HonkStonk/AeroQuad/Documentation/Architecture/AeroQuadSoftwareFlowDiagram.png

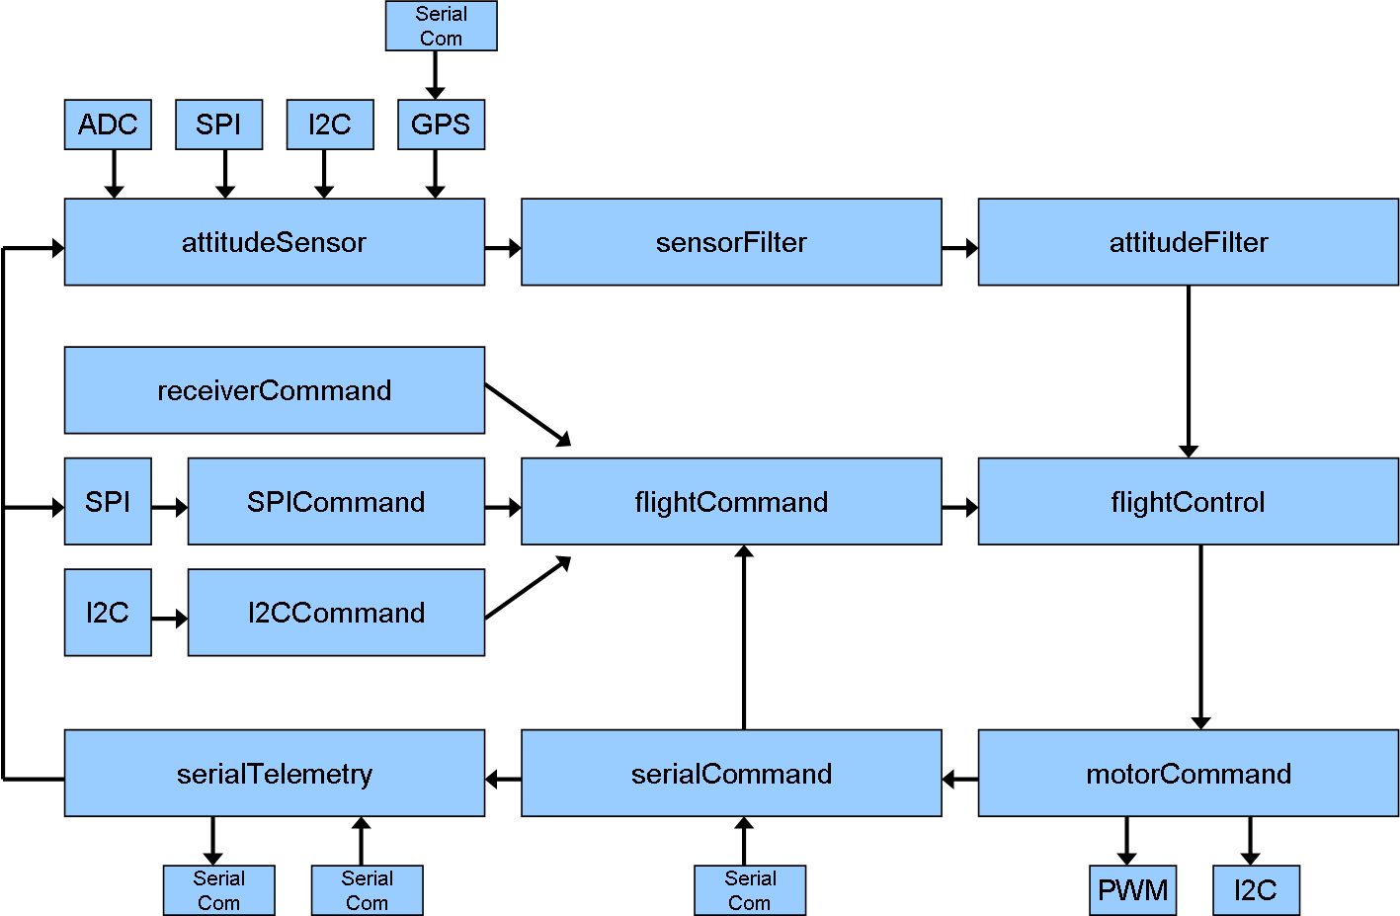
Documentation/Architecture/AeroQuadSoftwareFlowDiagram.png
