HonkStonk/AeroQuad/Documentation/InterconnectDiagram/v1.7/AeroQuadInterconnectDiagram_v1.7.jpg

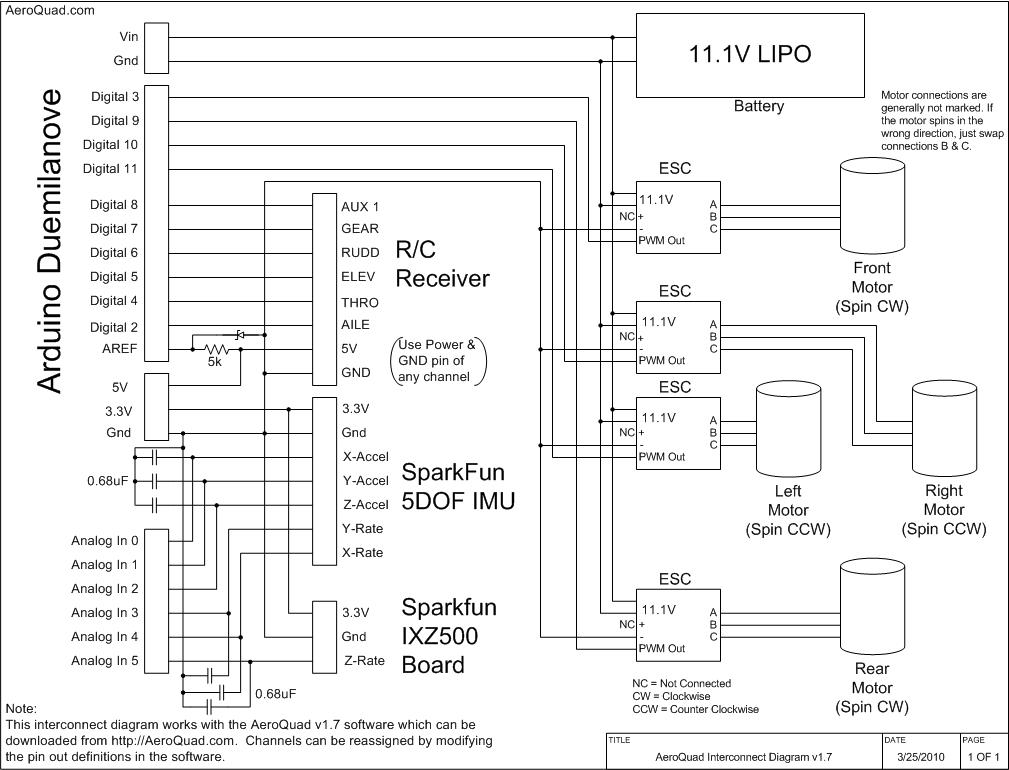
Documentation/InterconnectDiagram/v1.7/AeroQuadInterconnectDiagram_v1.7.jpg
