HonkStonk/AeroQuad/Documentation/Frame/v3.0/AeroQuadFrame_v3.dxf

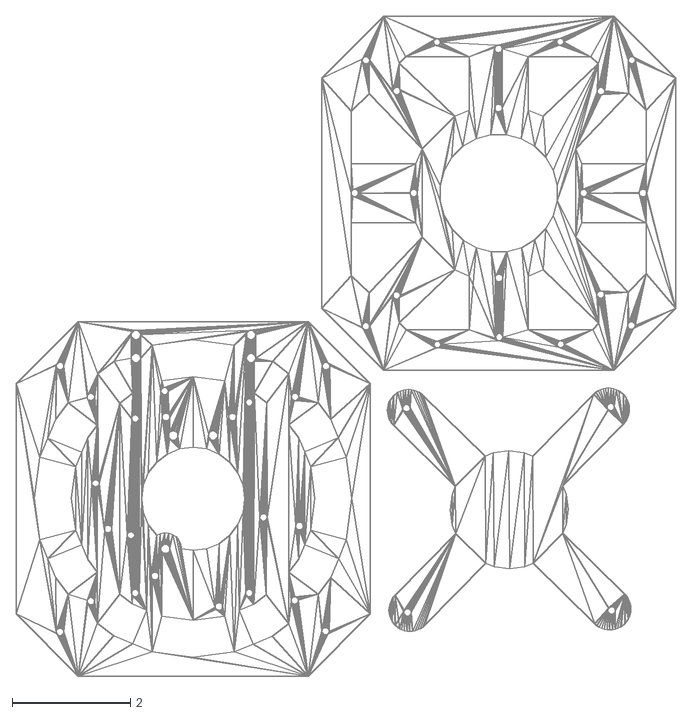
[picture p4: CAD file, 2010-09-20]
Documentation/Frame/v3.0/AeroQuadFrame_v3.dxf
11.2 x 11.2
