HonkStonk/AeroQuad/(list of files, cad)

Other CAD files:
Documentation/Frame/v1.0/Bottom.skp
Documentation/Frame/v1.0/BottomArm.skp
Documentation/Frame/v1.0/BottomSidePlate3D_125.skp
Documentation/Frame/v1.0/BottomSidePlate_125.skp
Documentation/Frame/v1.0/BottomSide_125.skp
Documentation/Frame/v1.0/Bottom_125.skp
Documentation/Frame/v1.0/QuadrocopterArm(bottom-side).skp
Documentation/Frame/v1.0/QuadrocopterArm.skp
Documentation/Frame/v1.1/BasePlates.skp
Documentation/Frame/v1.1/BottomSidePlatev2.skp
Documentation/Frame/v1.1/QuadArms.skp
Documentation/Frame/v1.1/QuadArms3D.skp
Documentation/Frame/v1.1/Xstruts.skp
Documentation/Frame/v1.2/BasePlates_v1.2.skp
Documentation/Frame/v1.2/QuadArms_v1.2.skp
Documentation/Frame/v1.2/Quad_v1.2.skp
Documentation/Frame/v2.0/12-5mmTubeMounts.skp
Documentation/Frame/v2.0/12-7mmTubeMounts.skp
Documentation/Frame/v2.0/AeroQuadFrame_v2.0.skp
Documentation/Frame/v2.1/12-7mmTubeMounts.skp
Documentation/Frame/v2.1/AeroQuadFrame3D_v2.1.skp
Documentation/Frame/v2.1/AeroQuadFrame_v2.1.skp
