HonkStonk/AeroQuad/Documentation/Shield/AeroQuad_v2.0/AeroQuad_v206_Schematic.pdf

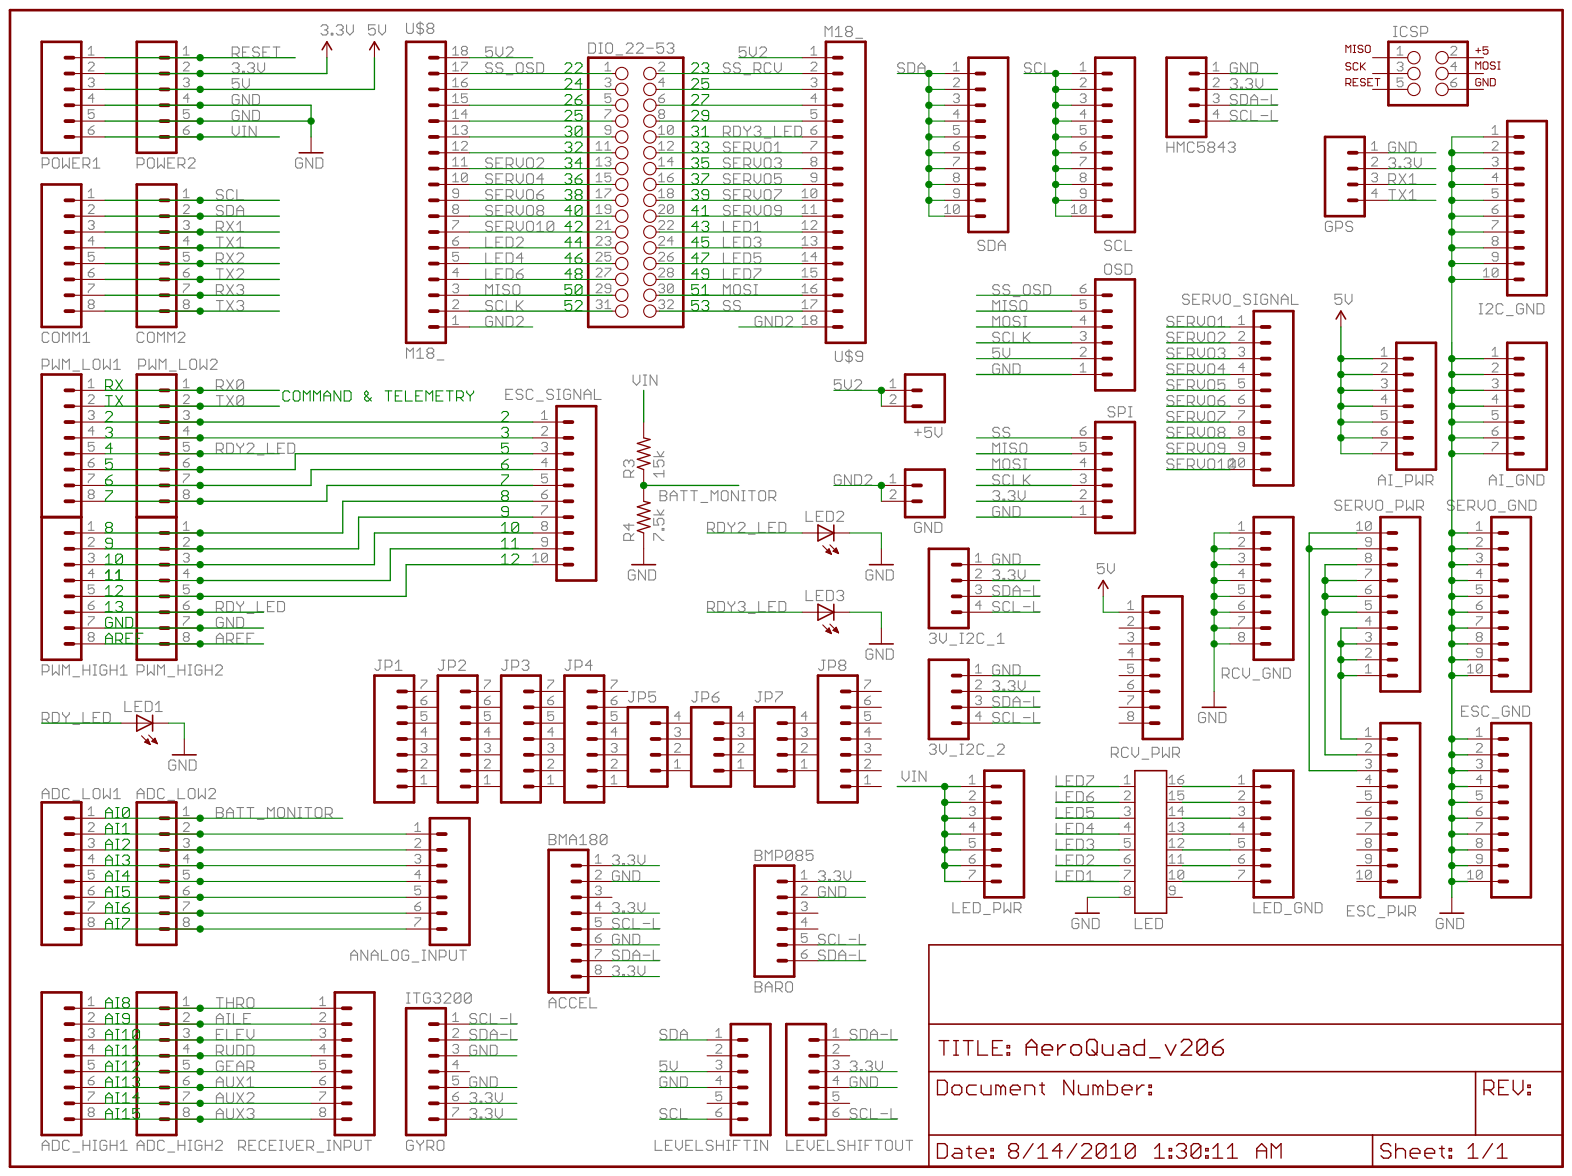
[picture p6: page 1]
