HonkStonk/AeroQuad/Documentation/Shield/AeroReceiver_v0.1/AeroReceiver01_Schematic.pdf

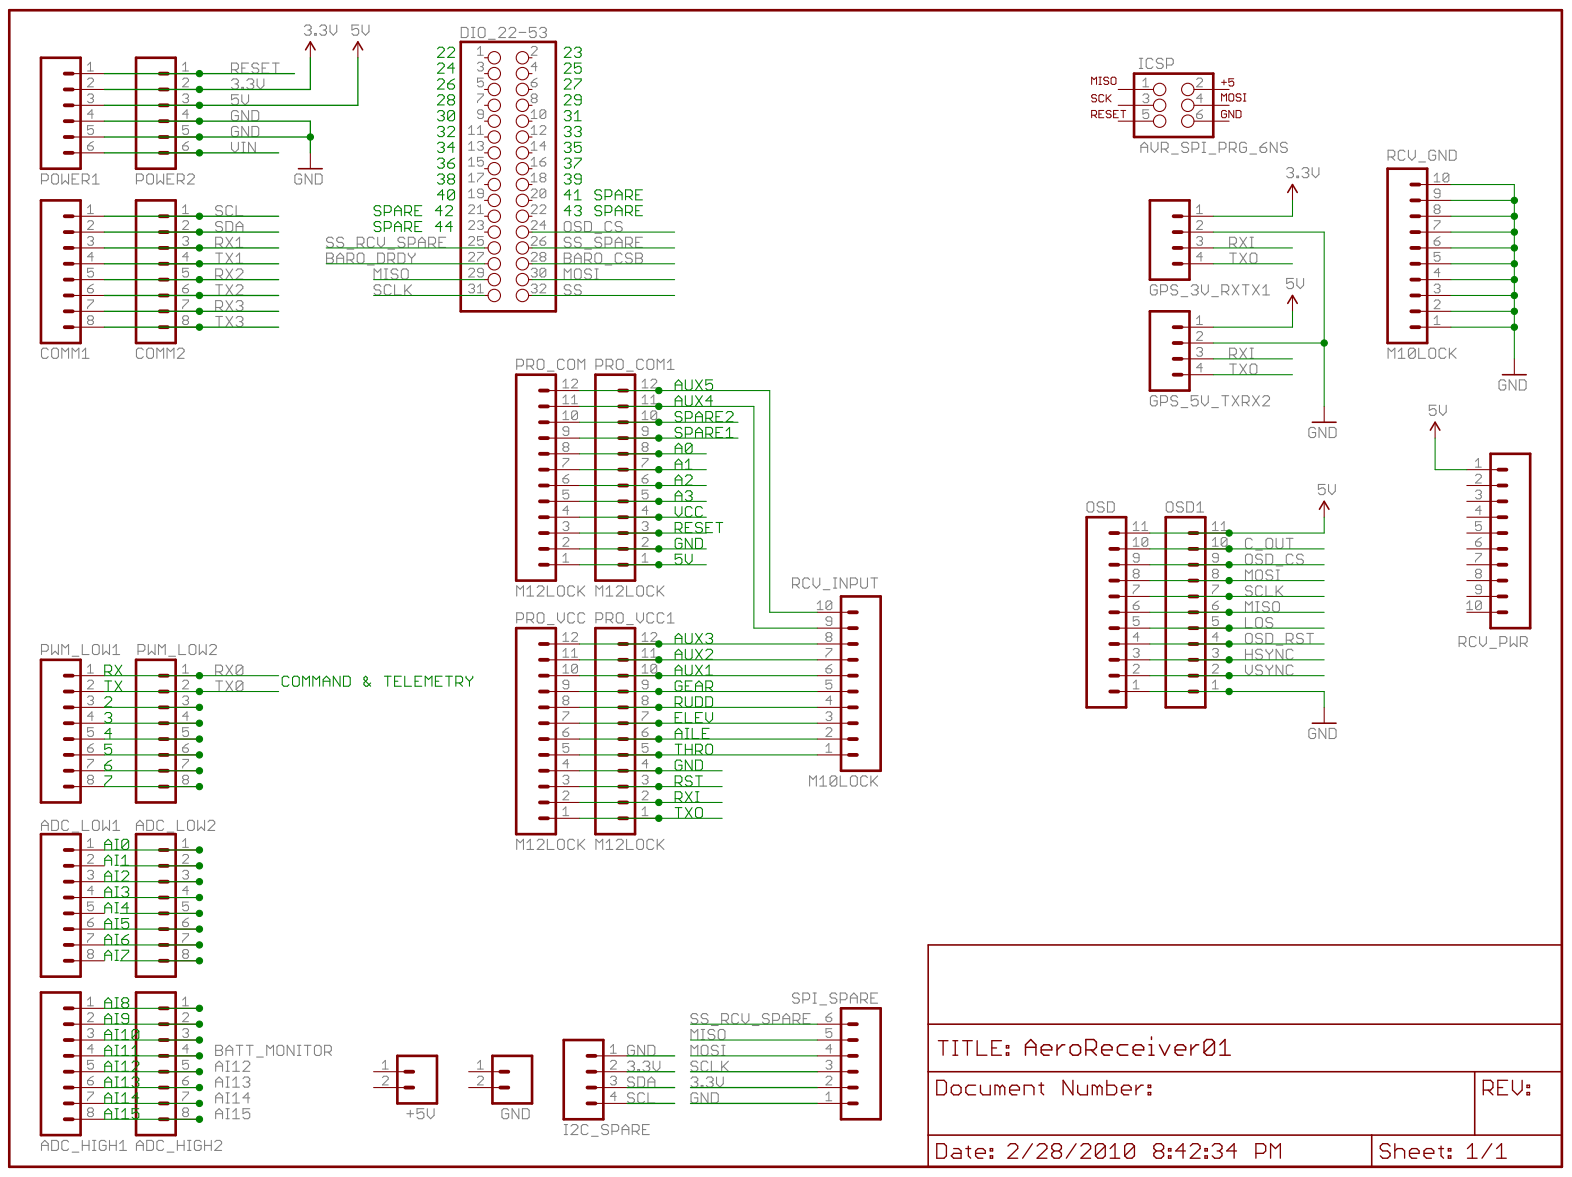
[picture p7: page 1]
