HonkStonk/AeroQuad/Documentation/Frame/v3.0/AeroQuadFrame_BasePlate_v3.0.pdf

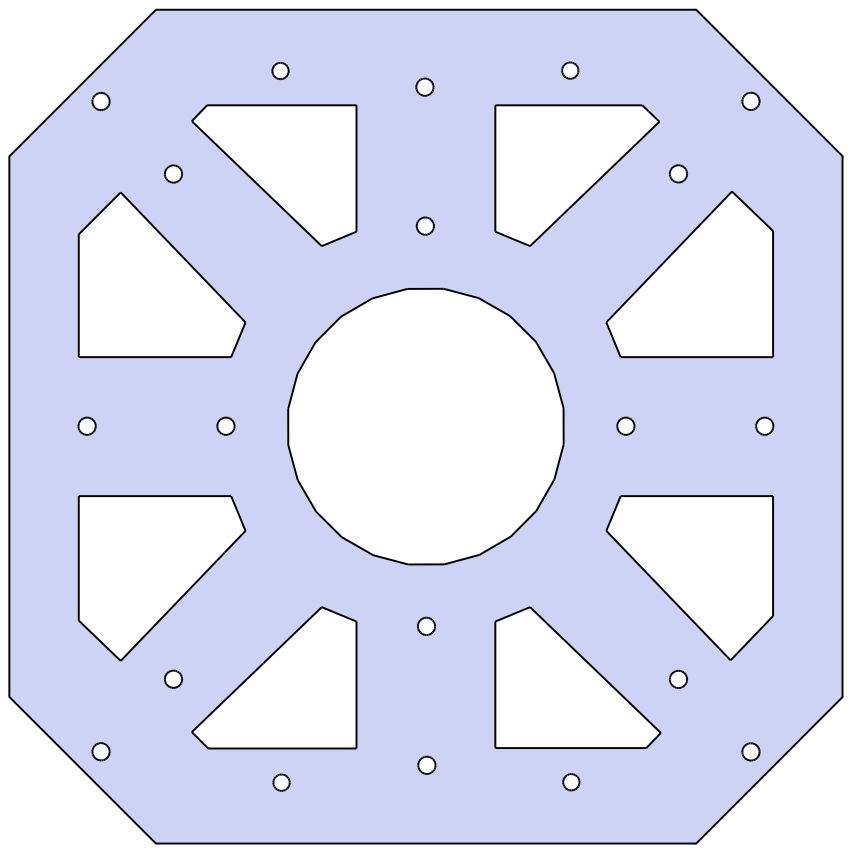
[picture p8: page 1]
