HonkStonk/AeroQuad/Documentation/Frame/v3.0/AeroQuadFrame_TopPlate_v3.pdf

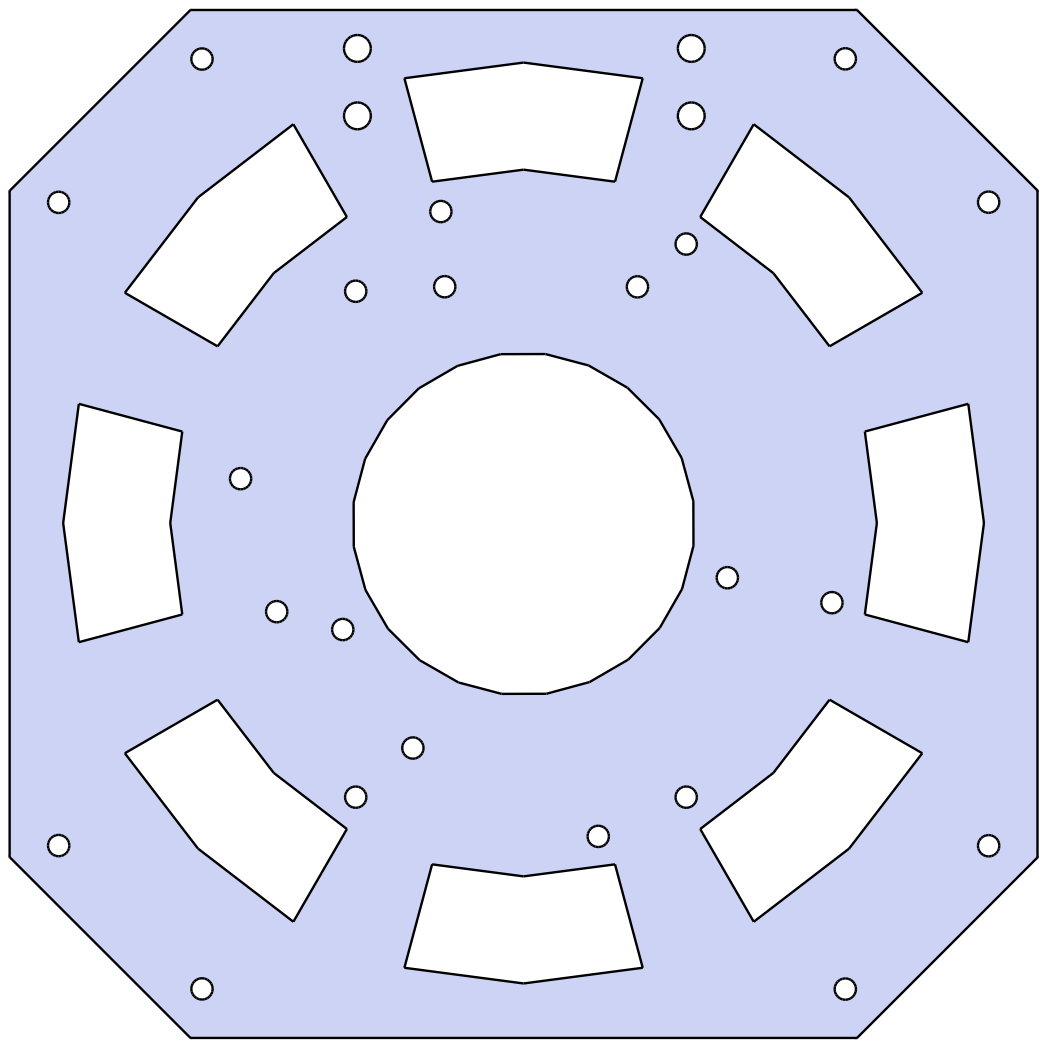
[picture p9: page 1]
