HonkStonk/AeroQuad/Documentation/Shield/AeroReceiver_v0.1/AeroReceiver01.pdf

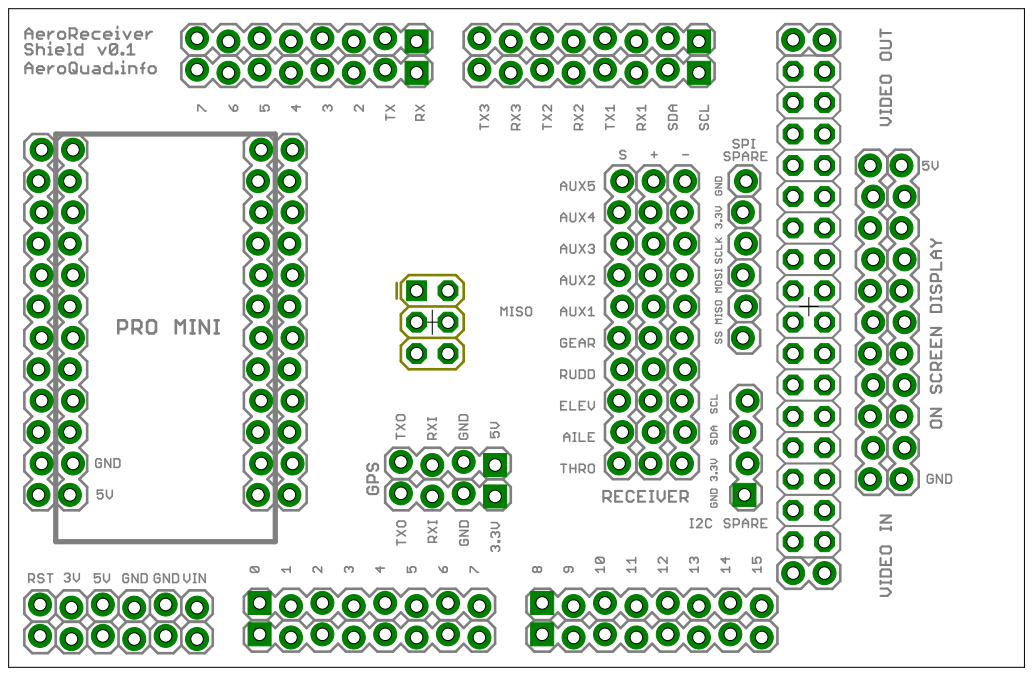
[picture p10: page 1]
