HonkStonk/AeroQuad/Documentation/Shield/AeroQuad_v1.8/AeroQuad_v18_Schematic.pdf

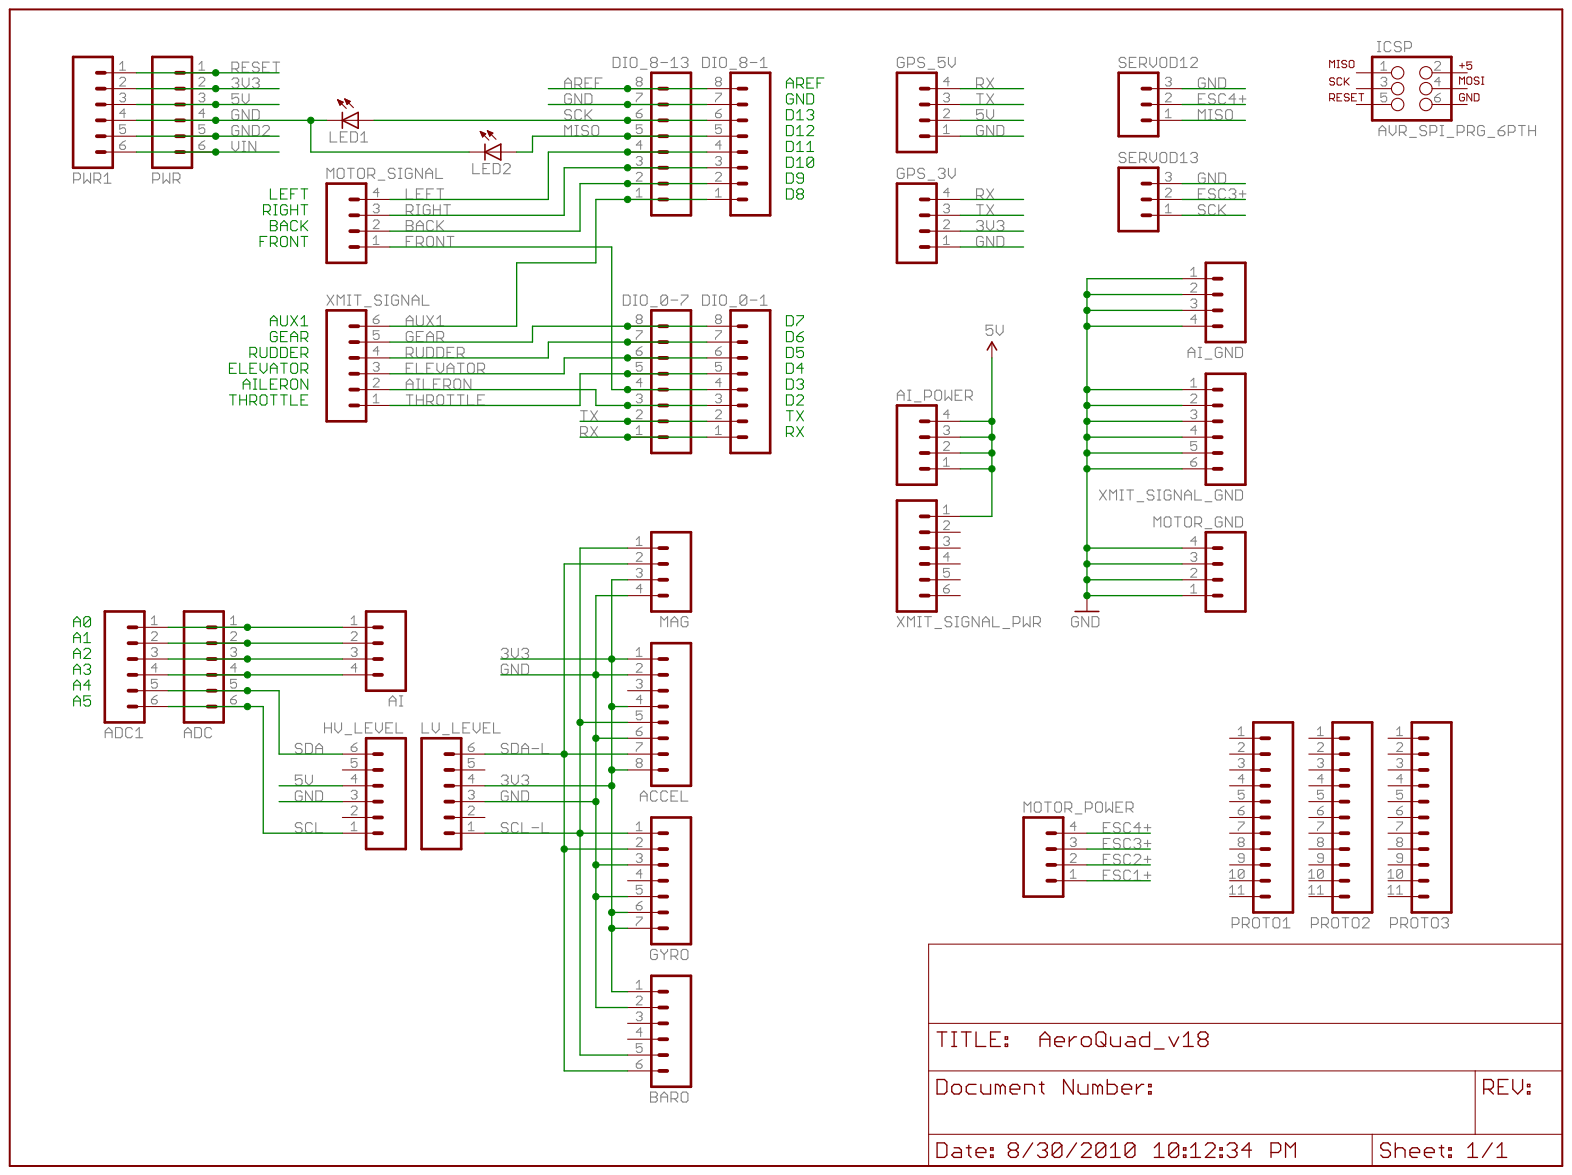
[picture p12: page 1]
