HonkStonk/AeroQuad/Documentation/Shield/AeroQuad_v1.7/AeroQuad_v17_Schematic.pdf

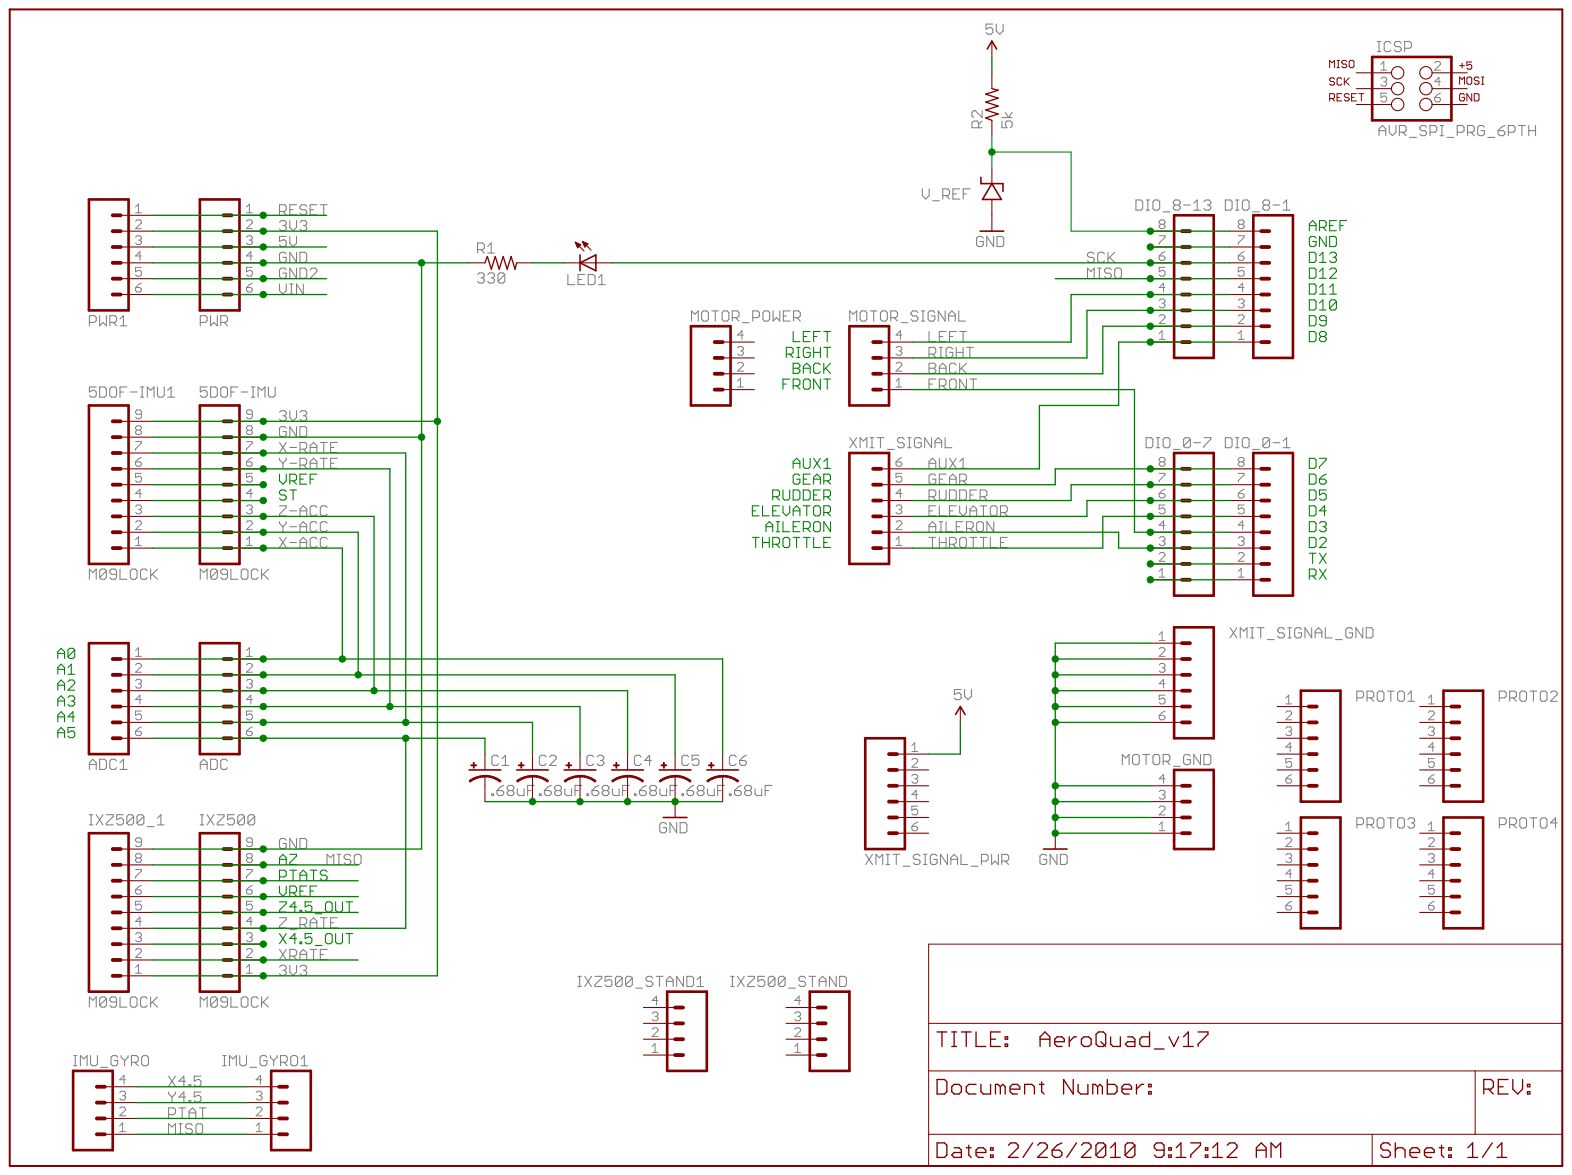
[picture p13: page 1]
