HonkStonk/AeroQuad/Documentation/Shield/AeroQuad_v1.7/AeroQuad_v17.pdf

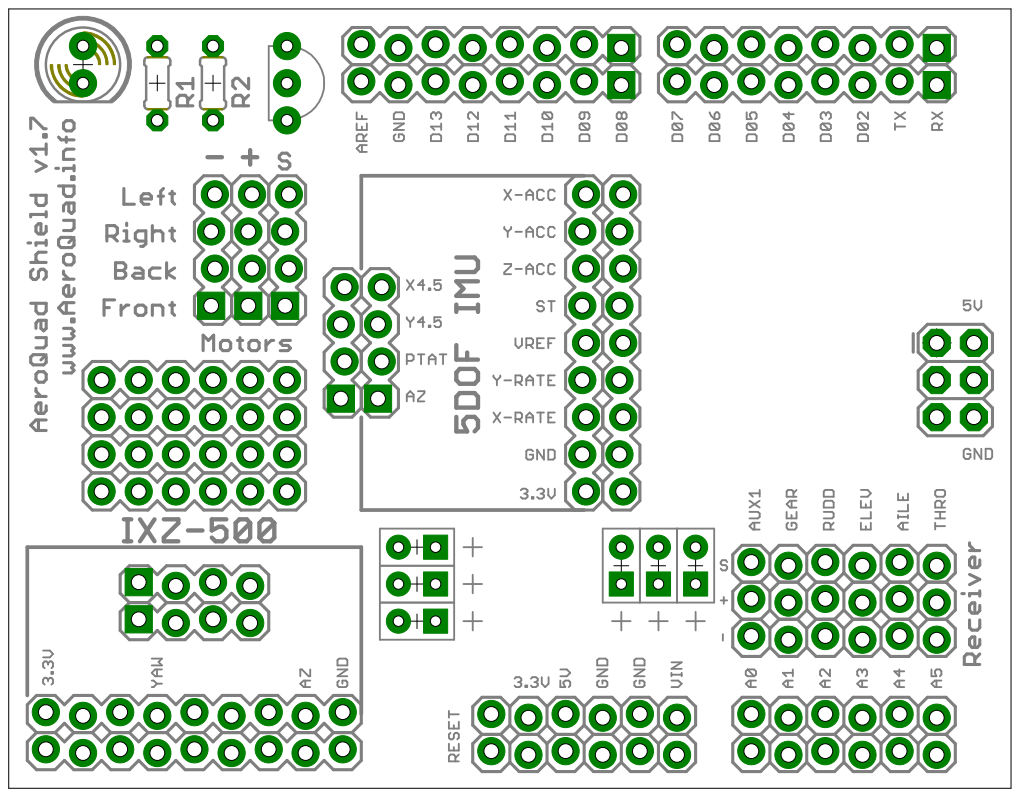
[picture p15: page 1]
