HonkStonk/AeroQuad/Documentation/Shield/AeroQuad_v1.6/AeroQuad_v16.pdf

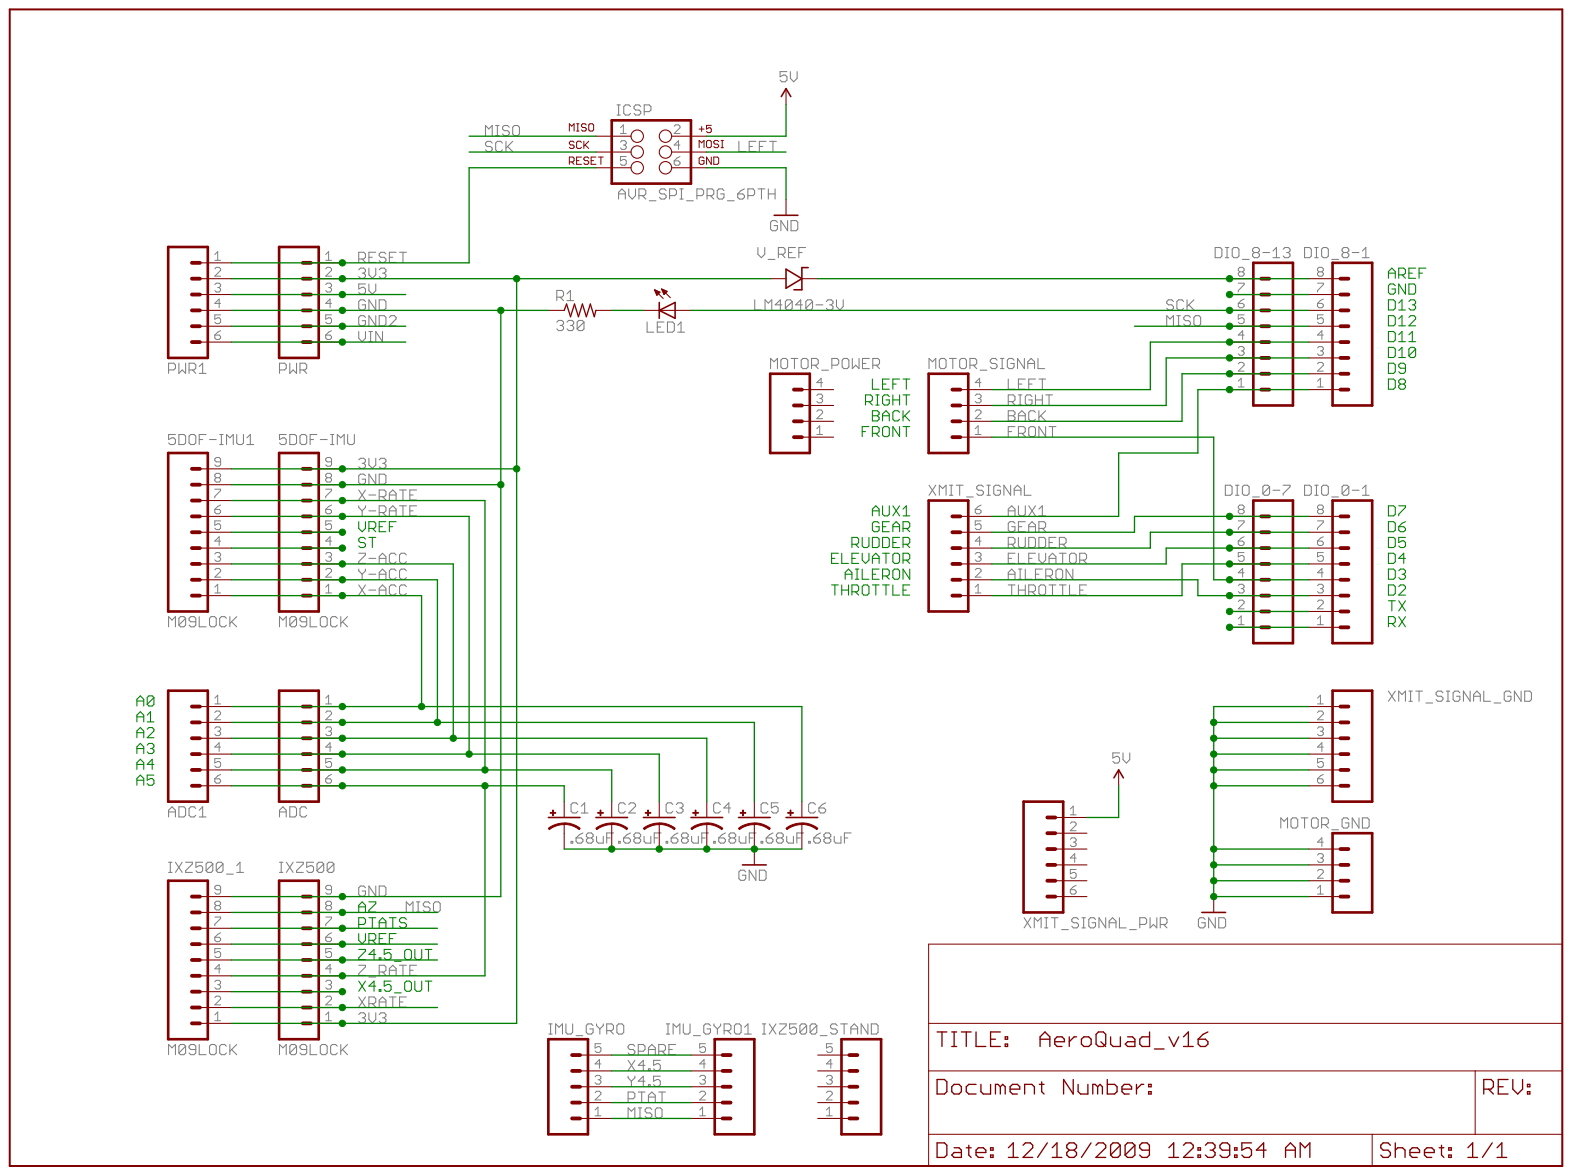
[picture p16: page 1]
