HonkStonk/AeroQuad/Documentation/Shield/AeroQuad_v1.5/AeroQuad_v15.pdf

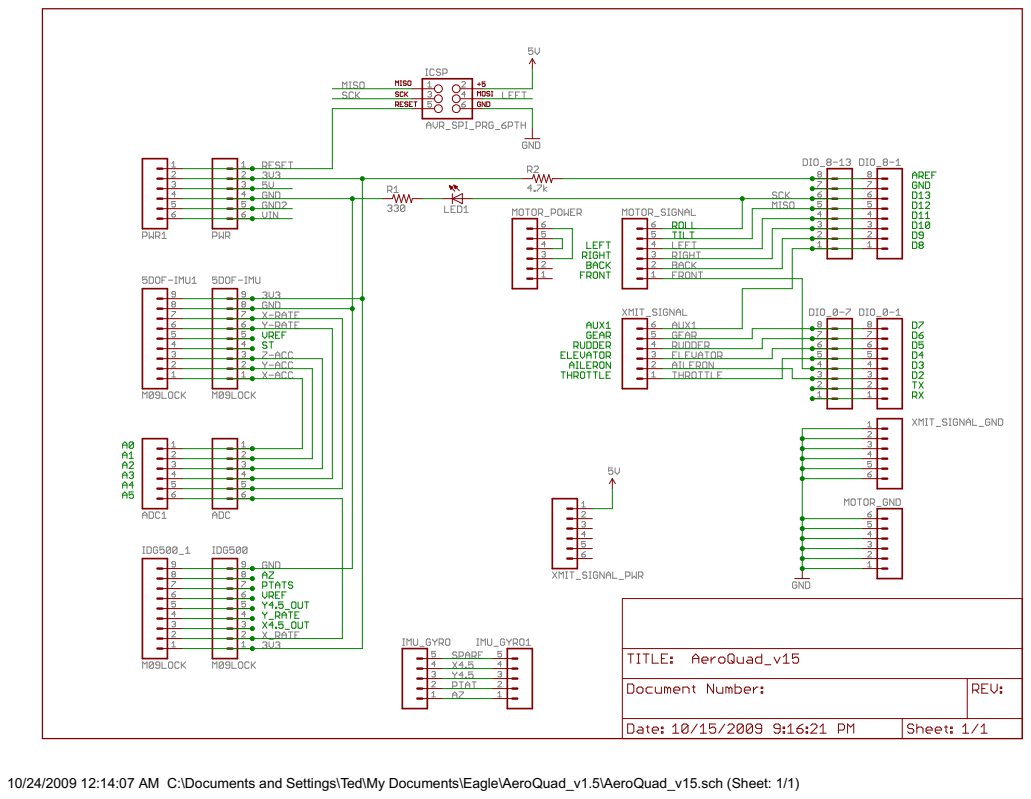
[picture p17: page 1]

10/24/2009 12:14:07 AM C:\Documents and Settings\Ted\My Documents\Eagle\AeroQuad_v1.5\AeroQuad_v15.sch (Sheet: 1/1)
