HonkStonk/AeroQuad/Documentation/Shield/AeroQuad_v1.4/AeroQuad_v14.pdf

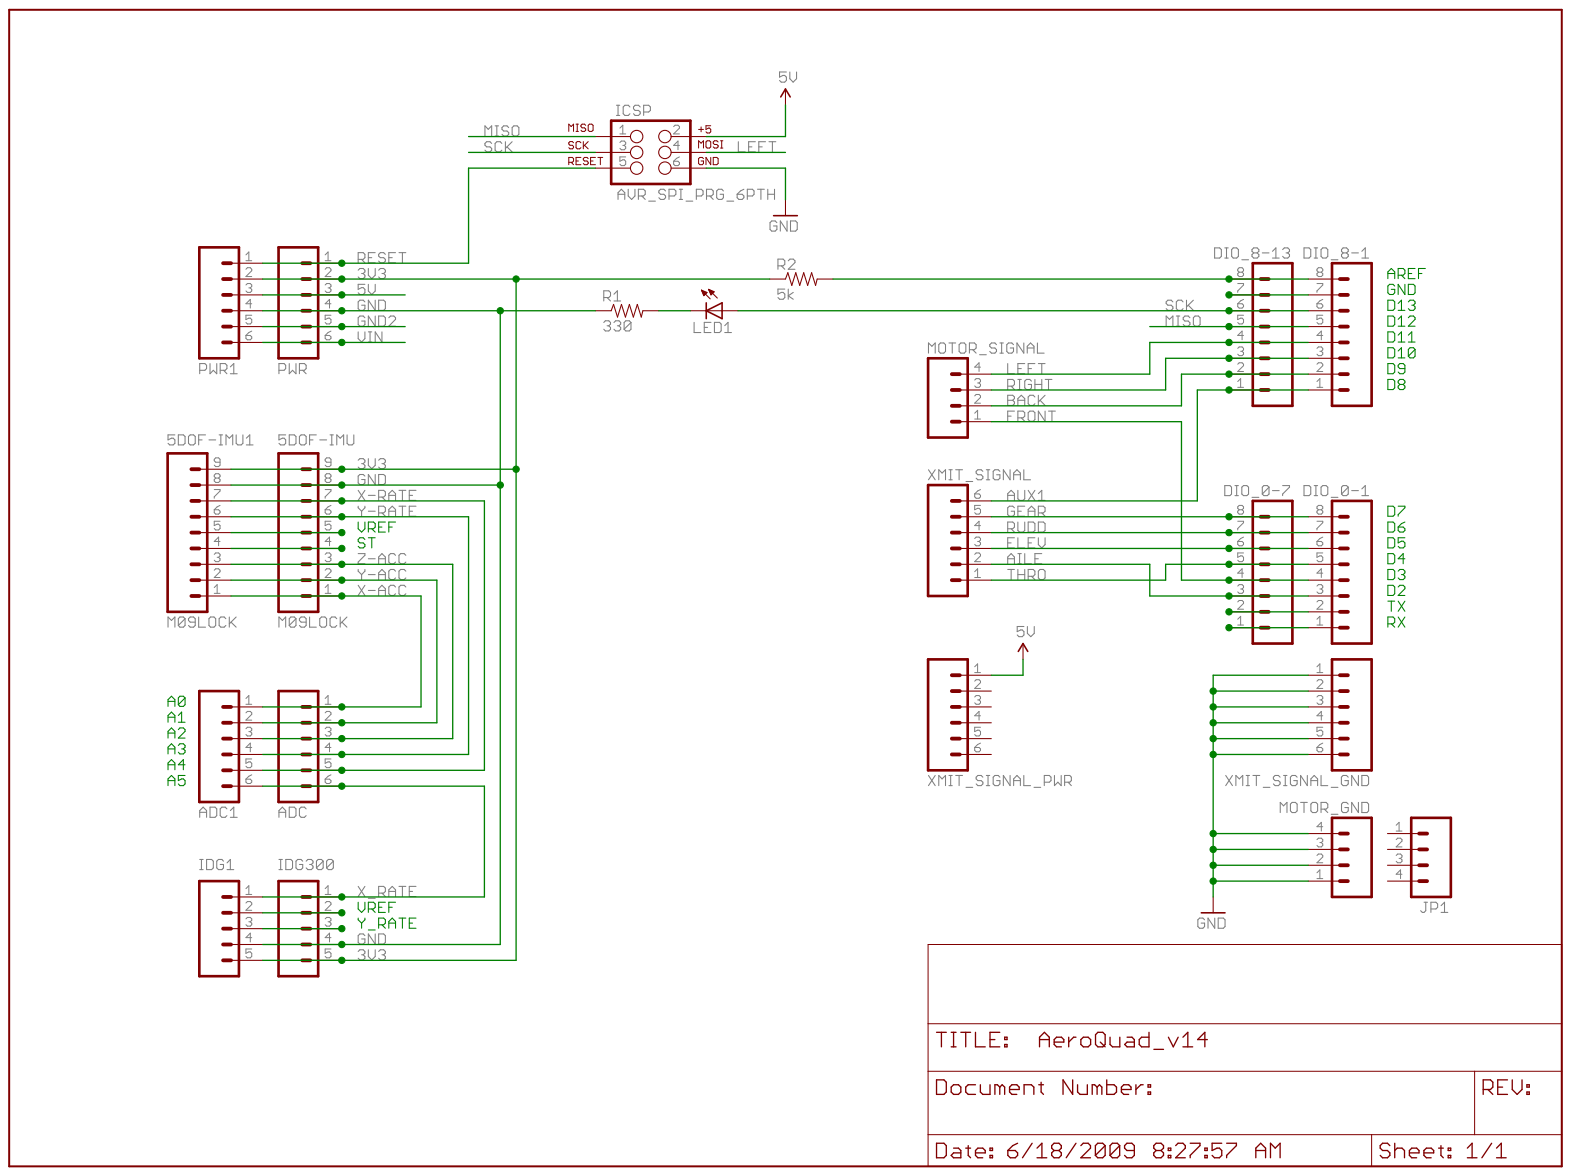
[picture p18: page 1]
