HonkStonk/AeroQuad/AeroQuad/DataStorage.h

/*
  AeroQuad v2.1 - October 2010
  www.AeroQuad.com
  Copyright (c) 2010 Ted Carancho.  All rights reserved.
  An Open Source Arduino based multicopter.
 
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
  You should have received a copy of the GNU General Public License 
  along with this program. If not, see <http://www.gnu.org/licenses/>. 
*/

// Utilities for writing and reading from the EEPROM
float readFloat(int address) {
  union floatStore {
    byte floatByte[4];
    float floatVal;
  } floatOut;
  
  for (int i = 0; i < 4; i++) 
    floatOut.floatByte[i] = EEPROM.read(address + i);
  return floatOut.floatVal;
}

void writeFloat(float value, int address) {
  union floatStore {
    byte floatByte[4];
    float floatVal;
  } floatIn;
  
  floatIn.floatVal = value;
  for (int i = 0; i < 4; i++) 
    EEPROM.write(address + i, floatIn.floatByte[i]);
}

// contains all default values when re-writing EEPROM
void initializeEEPROM(void) {
  PID[ROLL].P = 3.00; //Honk
  PID[ROLL].I = 0.0;
  PID[ROLL].D = -0.05; //Honk
  PID[PITCH].P = 3.00; //Honk
  PID[PITCH].I = 0.0;
  PID[PITCH].D = -0.05; //Honk
  PID[YAW].P = 3.0;
  PID[YAW].I = 0.0;
  PID[YAW].D = 0.0;
  PID[LEVELROLL].P = 7.0;
  PID[LEVELROLL].I = 20.0;
  PID[LEVELROLL].D = 0.0;
  PID[LEVELPITCH].P = 7.0;
  PID[LEVELPITCH].I = 20.0;
  PID[LEVELPITCH].D = 0.0;
  PID[HEADING].P = 3.0;
  PID[HEADING].I = 0.0;
  PID[HEADING].D = 0.0;
  PID[LEVELGYROROLL].P = 1.2;
  PID[LEVELGYROROLL].I = 0.0;
  PID[LEVELGYROROLL].D = -14.0;
  PID[LEVELGYROPITCH].P = 1.2;
  PID[LEVELGYROPITCH].I = 0.0;
  PID[LEVELGYROPITCH].D = -14.0;
  #ifdef AltitudeHold
    PID[ALTITUDE].P = 25.0;
    PID[ALTITUDE].I = 0.0;
    PID[ALTITUDE].D = 0.0;
    PID[ALTITUDE].windupGuard = 25.0;
    PID[ZDAMPENING].P = 0.0;
    PID[ZDAMPENING].I = 0.0;
    PID[ZDAMPENING].D = 0.0;
    minThrottleAdjust = -50.0;
    maxThrottleAdjust = 500.0;
    altitude.setSmoothFactor(0.1);
  #endif
  #ifdef HeadingMagHold
    compass.setRange(XAXIS, 1);
    compass.setOffset(XAXIS, 0);
    compass.setRange(YAXIS, 1);
    compass.setOffset(YAXIS, 0);
    compass.setRange(ZAXIS, 1);
    compass.setOffset(ZAXIS, 0);
  #endif
  windupGuard = 1000.0;
  receiver.setXmitFactor(0.20);  //Honk
  levelLimit = 500.0;
  levelOff = 150.0;
  gyro.setSmoothFactor(1.0);
  accel.setSmoothFactor(1.0);
  accel.setOneG(500);
  timeConstant = 7.0;   
  for (channel = ROLL; channel < LASTCHANNEL; channel++) {
    receiver.setTransmitterSlope(channel, 1.0);
    receiver.setTransmitterOffset(channel, 0.0);
  }
  receiver.setSmoothFactor(THROTTLE, 1.0);
  receiver.setSmoothFactor(ROLL, 1.0);
  receiver.setSmoothFactor(PITCH, 1.0);
  receiver.setSmoothFactor(YAW, 0.5);
  receiver.setSmoothFactor(MODE, 1.0);
  receiver.setSmoothFactor(AUX, 1.0);
  smoothHeading = 1.0;
  flightMode = ACRO;
  headingHoldConfig = OFF;
  minAcro = 1300;
  aref = 5.0; // Use 3.0 if using a v1.7 shield or use 2.8 for an AeroQuad Shield < v1.7
}

void readEEPROM(void) {
  PID[ROLL].P = readFloat(PGAIN_ADR);
  PID[ROLL].I = readFloat(IGAIN_ADR);
  PID[ROLL].D = readFloat(DGAIN_ADR);
  PID[ALTITUDE].windupGuard = readFloat(ALTITUDE_WINDUP_ADR);
  PID[ROLL].lastPosition = 0;
  PID[ROLL].integratedError = 0;
  
  PID[PITCH].P = readFloat(PITCH_PGAIN_ADR);
  PID[PITCH].I = readFloat(PITCH_IGAIN_ADR);
  PID[PITCH].D = readFloat(PITCH_DGAIN_ADR);
  PID[PITCH].lastPosition = 0;
  PID[PITCH].integratedError = 0;
  
  PID[YAW].P = readFloat(YAW_PGAIN_ADR);
  PID[YAW].I = readFloat(YAW_IGAIN_ADR);
  PID[YAW].D = readFloat(YAW_DGAIN_ADR);
  PID[YAW].lastPosition = 0;
  PID[YAW].integratedError = 0;
  
  PID[LEVELROLL].P = readFloat(LEVEL_PGAIN_ADR);
  PID[LEVELROLL].I = readFloat(LEVEL_IGAIN_ADR);
  PID[LEVELROLL].D = readFloat(LEVEL_DGAIN_ADR);
  PID[LEVELROLL].lastPosition = 0;
  PID[LEVELROLL].integratedError = 0;  
  
  PID[LEVELPITCH].P = readFloat(LEVEL_PITCH_PGAIN_ADR);
  PID[LEVELPITCH].I = readFloat(LEVEL_PITCH_IGAIN_ADR);
  PID[LEVELPITCH].D = readFloat(LEVEL_PITCH_DGAIN_ADR);
  PID[LEVELPITCH].lastPosition = 0;
  PID[LEVELPITCH].integratedError = 0;
  
  PID[HEADING].P = readFloat(HEADING_PGAIN_ADR);
  PID[HEADING].I = readFloat(HEADING_IGAIN_ADR);
  PID[HEADING].D = readFloat(HEADING_DGAIN_ADR);
  PID[HEADING].lastPosition = 0;
  PID[HEADING].integratedError = 0;
  
  PID[LEVELGYROROLL].P = readFloat(LEVEL_GYRO_ROLL_PGAIN_ADR);
  PID[LEVELGYROROLL].I = readFloat(LEVEL_GYRO_ROLL_IGAIN_ADR);
  PID[LEVELGYROROLL].D = readFloat(LEVEL_GYRO_ROLL_DGAIN_ADR);
  PID[LEVELGYROROLL].lastPosition = 0;
  PID[LEVELGYROROLL].integratedError = 0;
  
  PID[LEVELGYROPITCH].P = readFloat(LEVEL_GYRO_PITCH_PGAIN_ADR);
  PID[LEVELGYROPITCH].I = readFloat(LEVEL_GYRO_PITCH_IGAIN_ADR);
  PID[LEVELGYROPITCH].D = readFloat(LEVEL_GYRO_PITCH_DGAIN_ADR);
  PID[LEVELGYROPITCH].lastPosition = 0;
  PID[LEVELGYROPITCH].integratedError = 0;
  
  #ifdef AltitudeHold
    PID[ALTITUDE].P = readFloat(ALTITUDE_PGAIN_ADR);
    PID[ALTITUDE].I = readFloat(ALTITUDE_IGAIN_ADR);
    PID[ALTITUDE].D = readFloat(ALTITUDE_DGAIN_ADR);
    PID[ALTITUDE].lastPosition = 0;
    PID[ALTITUDE].integratedError = 0;
    PID[ZDAMPENING].P = readFloat(ZDAMP_PGAIN_ADR);
    PID[ZDAMPENING].I = readFloat(ZDAMP_IGAIN_ADR);
    PID[ZDAMPENING].D = readFloat(ZDAMP_DGAIN_ADR);
    PID[ZDAMPENING].lastPosition = 0;
    PID[ZDAMPENING].integratedError = 0;
    minThrottleAdjust = readFloat(ALTITUDE_MIN_THROTTLE_ADR);
    maxThrottleAdjust = readFloat(ALTITUDE_MAX_THROTTLE_ADR);
    altitude.setSmoothFactor(readFloat(ALTITUDE_SMOOTH_ADR));
  #endif

  #ifdef HeadingMagHold
    compass.setRange(XAXIS, readFloat(MAGXRANGE_ADR));
    compass.setOffset(XAXIS, readFloat(MAGXOFFSET_ADR));
    compass.setRange(YAXIS, readFloat(MAGYRANGE_ADR));
    compass.setOffset(YAXIS, readFloat(MAGYOFFSET_ADR));
    compass.setRange(ZAXIS, readFloat(MAGZRANGE_ADR));
    compass.setOffset(ZAXIS, readFloat(MAGZOFFSET_ADR));
  #endif

  windupGuard = readFloat(WINDUPGUARD_ADR);
  levelLimit = readFloat(LEVELLIMIT_ADR);
  levelOff = readFloat(LEVELOFF_ADR);
  timeConstant = readFloat(FILTERTERM_ADR);
  smoothHeading = readFloat(HEADINGSMOOTH_ADR);
  aref = readFloat(AREF_ADR);
  flightMode = readFloat(FLIGHTMODE_ADR);
  headingHoldConfig = readFloat(HEADINGHOLD_ADR);
  minAcro = readFloat(MINACRO_ADR);
  accel.setOneG(readFloat(ACCEL1G_ADR));
}

void writeEEPROM(void){
  cli(); // Needed so that APM sensor data doesn't overflow
  writeFloat(PID[ROLL].P, PGAIN_ADR);
  writeFloat(PID[ROLL].I, IGAIN_ADR);
  writeFloat(PID[ROLL].D, DGAIN_ADR);
  writeFloat(PID[PITCH].P, PITCH_PGAIN_ADR);
  writeFloat(PID[PITCH].I, PITCH_IGAIN_ADR);
  writeFloat(PID[PITCH].D, PITCH_DGAIN_ADR);
  writeFloat(PID[LEVELROLL].P, LEVEL_PGAIN_ADR);
  writeFloat(PID[LEVELROLL].I, LEVEL_IGAIN_ADR);
  writeFloat(PID[LEVELROLL].D, LEVEL_DGAIN_ADR);
  writeFloat(PID[LEVELPITCH].P, LEVEL_PITCH_PGAIN_ADR);
  writeFloat(PID[LEVELPITCH].I, LEVEL_PITCH_IGAIN_ADR);
  writeFloat(PID[LEVELPITCH].D, LEVEL_PITCH_DGAIN_ADR);
  writeFloat(PID[YAW].P, YAW_PGAIN_ADR);
  writeFloat(PID[YAW].I, YAW_IGAIN_ADR);
  writeFloat(PID[YAW].D, YAW_DGAIN_ADR);
  writeFloat(PID[HEADING].P, HEADING_PGAIN_ADR);
  writeFloat(PID[HEADING].I, HEADING_IGAIN_ADR);
  writeFloat(PID[HEADING].D, HEADING_DGAIN_ADR);
  writeFloat(PID[LEVELGYROROLL].P, LEVEL_GYRO_ROLL_PGAIN_ADR);
  writeFloat(PID[LEVELGYROROLL].I, LEVEL_GYRO_ROLL_IGAIN_ADR);
  writeFloat(PID[LEVELGYROROLL].D, LEVEL_GYRO_ROLL_DGAIN_ADR);
  writeFloat(PID[LEVELGYROPITCH].P, LEVEL_GYRO_PITCH_PGAIN_ADR);
  writeFloat(PID[LEVELGYROPITCH].I, LEVEL_GYRO_PITCH_IGAIN_ADR);
  writeFloat(PID[LEVELGYROPITCH].D, LEVEL_GYRO_PITCH_DGAIN_ADR);
  #ifdef AltitudeHold
    writeFloat(PID[ALTITUDE].P, ALTITUDE_PGAIN_ADR);
    writeFloat(PID[ALTITUDE].I, ALTITUDE_IGAIN_ADR);
    writeFloat(PID[ALTITUDE].D, ALTITUDE_DGAIN_ADR);
    writeFloat(PID[ALTITUDE].windupGuard, ALTITUDE_WINDUP_ADR);
    writeFloat(PID[ZDAMPENING].P, ZDAMP_PGAIN_ADR);
    writeFloat(PID[ZDAMPENING].I, ZDAMP_IGAIN_ADR);
    writeFloat(PID[ZDAMPENING].D, ZDAMP_DGAIN_ADR);
    writeFloat(minThrottleAdjust, ALTITUDE_MIN_THROTTLE_ADR);
    writeFloat(maxThrottleAdjust, ALTITUDE_MAX_THROTTLE_ADR);
    writeFloat(altitude.getSmoothFactor(), ALTITUDE_SMOOTH_ADR);
  #endif
  #ifdef HeadingMagHold
    writeFloat(compass.getRange(XAXIS), MAGXRANGE_ADR);
    writeFloat(compass.getOffset(XAXIS), MAGXOFFSET_ADR);
    writeFloat(compass.getRange(YAXIS), MAGYRANGE_ADR);
    writeFloat(compass.getOffset(YAXIS), MAGYOFFSET_ADR);
    writeFloat(compass.getRange(ZAXIS), MAGZRANGE_ADR);
    writeFloat(compass.getOffset(ZAXIS), MAGZOFFSET_ADR);
  #endif
  writeFloat(windupGuard, WINDUPGUARD_ADR);  
  writeFloat(levelLimit, LEVELLIMIT_ADR);   
  writeFloat(levelOff, LEVELOFF_ADR); 
  writeFloat(receiver.getXmitFactor(), XMITFACTOR_ADR);
  writeFloat(gyro.getSmoothFactor(), GYROSMOOTH_ADR);
  writeFloat(accel.getSmoothFactor(), ACCSMOOTH_ADR);
  writeFloat(receiver.getSmoothFactor(THROTTLE), THROTTLESMOOTH_ADR);
  writeFloat(receiver.getSmoothFactor(ROLL), ROLLSMOOTH_ADR);
  writeFloat(receiver.getSmoothFactor(PITCH), PITCHSMOOTH_ADR);
  writeFloat(receiver.getSmoothFactor(YAW), YAWSMOOTH_ADR);
  writeFloat(receiver.getSmoothFactor(MODE), MODESMOOTH_ADR);
  writeFloat(receiver.getSmoothFactor(AUX), AUXSMOOTH_ADR);
  writeFloat(timeConstant, FILTERTERM_ADR);
  writeFloat(receiver.getTransmitterSlope(THROTTLE), THROTTLESCALE_ADR);
  writeFloat(receiver.getTransmitterOffset(THROTTLE), THROTTLEOFFSET_ADR);
  writeFloat(receiver.getTransmitterSlope(ROLL), ROLLSCALE_ADR);
  writeFloat(receiver.getTransmitterOffset(ROLL), ROLLOFFSET_ADR);
  writeFloat(receiver.getTransmitterSlope(PITCH), PITCHSCALE_ADR);
  writeFloat(receiver.getTransmitterOffset(PITCH), PITCHOFFSET_ADR);
  writeFloat(receiver.getTransmitterSlope(YAW), YAWSCALE_ADR);
  writeFloat(receiver.getTransmitterOffset(YAW), YAWOFFSET_ADR);
  writeFloat(receiver.getTransmitterSlope(MODE), MODESCALE_ADR);
  writeFloat(receiver.getTransmitterOffset(MODE), MODEOFFSET_ADR);
  writeFloat(receiver.getTransmitterSlope(AUX), AUXSCALE_ADR);
  writeFloat(receiver.getTransmitterOffset(AUX), AUXOFFSET_ADR);
  writeFloat(smoothHeading, HEADINGSMOOTH_ADR);
  writeFloat(aref, AREF_ADR);
  writeFloat(flightMode, FLIGHTMODE_ADR);
  writeFloat(headingHoldConfig, HEADINGHOLD_ADR);
  writeFloat(minAcro, MINACRO_ADR);
  writeFloat(accel.getOneG(), ACCEL1G_ADR);
  sei(); // Restart interrupts
}
