HonkStonk/AeroQuad/AeroQuad/SerialCom.pde

/*
  AeroQuad v2.1 - October 2010
  www.AeroQuad.com
  Copyright (c) 2010 Ted Carancho.  All rights reserved.
  An Open Source Arduino based multicopter.
 
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
  You should have received a copy of the GNU General Public License 
  along with this program. If not, see <http://www.gnu.org/licenses/>. 
*/

// SerialCom.pde is responsible for the serial communication for commands and telemetry from the AeroQuad
// This comtains readSerialCommand() which listens for a serial command and it's arguments
// This also contains readSerialTelemetry() which listens for a telemetry request and responds with the requested data
// For more information on each command/telemetry look at: http://aeroquad.com/content.php?117

//***************************************************************************************************
//********************************** Serial Commands ************************************************
//***************************************************************************************************
void readSerialCommand() {
  // Check for serial message
  if (Serial.available()) {
    digitalWrite(LEDPIN, LOW);
    queryType = Serial.read();
    switch (queryType) {
    case 'A': // Receive roll and pitch gyro PID
      PID[ROLL].P = readFloatSerial();
      PID[ROLL].I = readFloatSerial();
      PID[ROLL].D = readFloatSerial();
      PID[ROLL].lastPosition = 0;
      PID[ROLL].integratedError = 0;
      PID[PITCH].P = readFloatSerial();
      PID[PITCH].I = readFloatSerial();
      PID[PITCH].D = readFloatSerial();
      PID[PITCH].lastPosition = 0;
      PID[PITCH].integratedError = 0;
      minAcro = readFloatSerial();
      break;
    case 'C': // Receive yaw PID
      PID[YAW].P = readFloatSerial();
      PID[YAW].I = readFloatSerial();
      PID[YAW].D = readFloatSerial();
      PID[YAW].lastPosition = 0;
      PID[YAW].integratedError = 0;
      PID[HEADING].P = readFloatSerial();
      PID[HEADING].I = readFloatSerial();
      PID[HEADING].D = readFloatSerial();
      PID[HEADING].lastPosition = 0;
      PID[HEADING].integratedError = 0;
      headingHoldConfig = readFloatSerial();
      heading = 0;
      relativeHeading = 0;
      headingHold = 0;
      break;
    case 'E': // Receive roll and pitch auto level PID
      PID[LEVELROLL].P = readFloatSerial();
      PID[LEVELROLL].I = readFloatSerial();
      PID[LEVELROLL].D = readFloatSerial();
      PID[LEVELROLL].lastPosition = 0;
      PID[LEVELROLL].integratedError = 0;
      PID[LEVELPITCH].P = readFloatSerial();
      PID[LEVELPITCH].I = readFloatSerial();
      PID[LEVELPITCH].D = readFloatSerial();
      PID[LEVELPITCH].lastPosition = 0;
      PID[LEVELPITCH].integratedError = 0;
      PID[LEVELGYROROLL].P = readFloatSerial();
      PID[LEVELGYROROLL].I = readFloatSerial();
      PID[LEVELGYROROLL].D = readFloatSerial();
      PID[LEVELGYROROLL].lastPosition = 0;
      PID[LEVELGYROROLL].integratedError = 0;
      PID[LEVELGYROPITCH].P = readFloatSerial();
      PID[LEVELGYROPITCH].I = readFloatSerial();
      PID[LEVELGYROPITCH].D = readFloatSerial();
      PID[LEVELGYROPITCH].lastPosition = 0;
      PID[LEVELGYROPITCH].integratedError = 0;
      windupGuard = readFloatSerial();
      break;
    case 'G': // Receive auto level configuration
      levelLimit = readFloatSerial();
      levelOff = readFloatSerial();
      break;
    case 'I': // Receiver altitude hold PID
      #ifdef AltitudeHold
        PID[ALTITUDE].P = readFloatSerial();
        PID[ALTITUDE].I = readFloatSerial();
        PID[ALTITUDE].D = readFloatSerial();
        PID[ALTITUDE].windupGuard = readFloatSerial();
        PID[ALTITUDE].lastPosition = 0;
        PID[ALTITUDE].integratedError = 0;
        minThrottleAdjust = readFloatSerial();
        maxThrottleAdjust = readFloatSerial();
        altitude.setSmoothFactor(readFloatSerial());
        PID[ZDAMPENING].P = readFloatSerial();
        PID[ZDAMPENING].I = readFloatSerial();
        PID[ZDAMPENING].D = readFloatSerial();
      #endif
      break;
    case 'K': // Receive data filtering values
      gyro.setSmoothFactor(readFloatSerial());
      accel.setSmoothFactor(readFloatSerial());
      timeConstant = readFloatSerial();
      //flightMode = readFloatSerial();
      break;
    case 'M': // Receive transmitter smoothing values
      receiver.setXmitFactor(readFloatSerial());
      receiver.setSmoothFactor(ROLL, readFloatSerial());
      receiver.setSmoothFactor(PITCH, readFloatSerial());
      receiver.setSmoothFactor(YAW, readFloatSerial());
      receiver.setSmoothFactor(THROTTLE, readFloatSerial());
      receiver.setSmoothFactor(MODE, readFloatSerial());
      receiver.setSmoothFactor(AUX, readFloatSerial());
      break;
    case 'O': // Receive transmitter calibration values
      receiver.setTransmitterSlope(ROLL, readFloatSerial());
      receiver.setTransmitterOffset(ROLL, readFloatSerial());
      receiver.setTransmitterSlope(PITCH, readFloatSerial());
      receiver.setTransmitterOffset(PITCH, readFloatSerial());
      receiver.setTransmitterSlope(YAW, readFloatSerial());
      receiver.setTransmitterOffset(YAW, readFloatSerial());
      receiver.setTransmitterSlope(THROTTLE, readFloatSerial());
      receiver.setTransmitterOffset(THROTTLE, readFloatSerial());
      receiver.setTransmitterSlope(MODE, readFloatSerial());
      receiver.setTransmitterOffset(MODE, readFloatSerial());
      receiver.setTransmitterSlope(AUX, readFloatSerial());
      receiver.setTransmitterOffset(AUX, readFloatSerial());
      break;
    case 'W': // Write all user configurable values to EEPROM
      writeEEPROM(); // defined in DataStorage.h
      zeroIntegralError();
      break;
    case 'Y': // Initialize EEPROM with default values
      initializeEEPROM(); // defined in DataStorage.h
      gyro.calibrate();
      accel.calibrate();
      zeroIntegralError();
      break;
    case '1': // Calibrate ESCS's by setting Throttle high on all channels
      armed = 0;
      calibrateESC = 1;
      break;
    case '2': // Calibrate ESC's by setting Throttle low on all channels
      armed = 0;
      calibrateESC = 2;
      break;
    case '3': // Test ESC calibration
      armed = 0;
      testCommand = readFloatSerial();
      calibrateESC = 3;
      break;
    case '4': // Turn off ESC calibration
      armed = 0;
      calibrateESC = 0;
      testCommand = 1000;
      break;
    case '5': // Send individual motor commands (motor, command)
      armed = 0;
      calibrateESC = 5;
      for (motor = FRONT; motor < LASTMOTOR; motor++)
        motors.setRemoteCommand(motor, readFloatSerial());
      break;
    case 'a':
      // spare
      break;
    case 'b': // calibrate gyros
      gyro.calibrate();
      flightAngle.calibrate();
      break;
    case 'c': // calibrate accels
      accel.calibrate();
      accel.setOneG(accel.getFlightData(ZAXIS));
      break;
    case 'd': // send aref
      aref = readFloatSerial();
      break;
    case 'f': // calibrate magnetometer
      #ifdef HeadingMagHold
      compass.setRange(XAXIS, readFloatSerial());
      compass.setOffset(XAXIS, readFloatSerial());
      compass.setRange(YAXIS, readFloatSerial());
      compass.setOffset(YAXIS, readFloatSerial());
      compass.setRange(ZAXIS, readFloatSerial());
      compass.setOffset(ZAXIS, readFloatSerial());
      #endif
      break;
    }
  digitalWrite(LEDPIN, HIGH);
  }
}

//***************************************************************************************************
//********************************* Serial Telemetry ************************************************
//***************************************************************************************************
void sendSerialTelemetry() {
  update = 0;
  switch (queryType) {
  case '=': // Reserved debug command to view any variable from Serial Monitor
//    Serial.print(accel.getZaxis());
//    comma();
//    Serial.print(holdAltitude);
//    comma();
//    #ifdef AltitudeHold
//    Serial.print(altitude.getData());
//    #else
//    Serial.print(-1);
//    #endif
//    comma();
//    Serial.print(throttleAdjust);
//    Serial.println();
Serial.print("T: ");
Serial.print(G_Dt, DEC);
Serial.print("s");
comma();
Serial.print("f: ");
Serial.print(1/G_Dt, DEC);
Serial.print("Hz");
comma();
Serial.print("oneg: ");
Serial.print(accel.getOneG());
comma();
Serial.print("Zaxis");
Serial.println(accel.getZaxis());

    //queryType = 'X';
    break;
  case 'B': // Send roll and pitch gyro PID values
    Serial.print(PID[ROLL].P);
    comma();
    Serial.print(PID[ROLL].I);
    comma();
    Serial.print(PID[ROLL].D);
    comma();
    //Serial.print(PID[ALTITUDE].windupGuard); //HONK
 	//comma();
    Serial.print(PID[PITCH].P);
    comma();
    Serial.print(PID[PITCH].I);
    comma();
    Serial.print(PID[PITCH].D);
    comma();
    Serial.println(minAcro);
    queryType = 'X';
    break;
  case 'D': // Send yaw PID values
    Serial.print(PID[YAW].P);
    comma();
    Serial.print(PID[YAW].I);
    comma();
    Serial.print(PID[YAW].D);
    comma();
    Serial.print(PID[HEADING].P);
    comma();
    Serial.print(PID[HEADING].I);
    comma();
    Serial.print(PID[HEADING].D);
    comma();
    Serial.println(headingHoldConfig, BIN);
    queryType = 'X';
    break;
  case 'F': // Send roll and pitch auto level PID values
    Serial.print(PID[LEVELROLL].P);
    comma();
    Serial.print(PID[LEVELROLL].I);
    comma();
    Serial.print(PID[LEVELROLL].D);
    comma();
    Serial.print(PID[LEVELPITCH].P);
    comma();
    Serial.print(PID[LEVELPITCH].I);
    comma();
    Serial.print(PID[LEVELPITCH].D);
    comma();
    Serial.print(PID[LEVELGYROROLL].P);
    comma();
    Serial.print(PID[LEVELGYROROLL].I);
    comma();
    Serial.print(PID[LEVELGYROROLL].D);
    comma();
    Serial.print(PID[LEVELGYROPITCH].P);
    comma();
    Serial.print(PID[LEVELGYROPITCH].I);
    comma();
    Serial.print(PID[LEVELGYROPITCH].D);
    comma();
    Serial.println(windupGuard);
    queryType = 'X';
    break;
  case 'H': // Send auto level configuration values
    Serial.print(levelLimit);
    comma();
    Serial.println(levelOff);
    queryType = 'X';
    break;
  case 'J': // Altitude Hold
    #ifdef AltitudeHold
      Serial.print(PID[ALTITUDE].P);
      comma();
      Serial.print(PID[ALTITUDE].I);
      comma();
      Serial.print(PID[ALTITUDE].D);
      comma();
      Serial.print(minThrottleAdjust);
      comma();
      Serial.print(maxThrottleAdjust);
      comma();
      Serial.print(altitude.getSmoothFactor());
      comma();
      Serial.print(PID[ZDAMPENING].P);
      comma();
      Serial.print(PID[ZDAMPENING].I);
      comma();
      Serial.println(PID[ZDAMPENING].D);
    #else
      Serial.print('0');
      comma();
      Serial.print('0');
      comma();
      Serial.print('0');
      comma();
      Serial.print('0');
      comma();
      Serial.print('0');
      comma();
      Serial.print('0');
      comma();
      Serial.print('0');
      comma();
      Serial.print('0');
      comma();
      Serial.println('0');
    #endif
    queryType = 'X';
    break;
  case 'L': // Send data filtering values
    Serial.print(gyro.getSmoothFactor());
    comma();
    Serial.print(accel.getSmoothFactor());
    comma();
    Serial.println(timeConstant);
    // comma();
    // Serial.println(flightMode, DEC);
   queryType = 'X';
    break;
  case 'N': // Send transmitter smoothing values
    Serial.print(receiver.getXmitFactor());
    comma();
    for (axis = ROLL; axis < AUX; axis++) {
      Serial.print(receiver.getSmoothFactor(axis));
      comma();
    }
    Serial.println(receiver.getSmoothFactor(AUX));
    queryType = 'X';
    break;
  case 'P': // Send transmitter calibration data
    for (axis = ROLL; axis < AUX; axis++) {
      Serial.print(receiver.getTransmitterSlope(axis));
      comma();
      Serial.print(receiver.getTransmitterOffset(axis));
      comma();
    }
    Serial.print(receiver.getTransmitterSlope(AUX));
    comma();
    Serial.println(receiver.getTransmitterOffset(AUX));
    queryType = 'X';
    break;
  case 'Q': // Send sensor data
    for (axis = ROLL; axis < LASTAXIS; axis++) {
      Serial.print(gyro.getData(axis));
      comma();
    }
    for (axis = ROLL; axis < LASTAXIS; axis++) {
      Serial.print(accel.getData(axis));
      comma();
    }
    for (axis = ROLL; axis < YAW; axis++) {
      Serial.print(levelAdjust[axis]);
      comma();
    }
    Serial.print(flightAngle.getData(ROLL));
    comma();
    Serial.print(flightAngle.getData(PITCH));
    Serial.println();
    break;
  case 'R': // Raw magnetometer data
 	#ifdef HeadingMagHold
      Serial.print(compass.getRawData(XAXIS));
      comma();
      Serial.print(compass.getRawData(YAXIS));
      comma();
      Serial.println(compass.getRawData(ZAXIS));
 	#endif
    break;
  case 'S': // Send all flight data
    Serial.print(deltaTime);
    comma();
    for (axis = ROLL; axis < LASTAXIS; axis++) {
      Serial.print(gyro.getFlightData(axis));
      comma();
    }
    Serial.print(receiver.getData(THROTTLE));
    comma();
    for (axis = ROLL; axis < LASTAXIS; axis++) {
      Serial.print(motors.getMotorAxisCommand(axis));
      comma();
    }
    for (motor = FRONT; motor < LASTMOTOR; motor++) {
      Serial.print(motors.getMotorCommand(motor));
      comma();
    }
    for (axis = ROLL; axis < LASTAXIS; axis++) {
      Serial.print(accel.getFlightData(axis));
      comma();
    }
     Serial.print(armed, BIN);
    comma();
    if (flightMode == STABLE)
      Serial.print(2000);
    if (flightMode == ACRO)
      Serial.print(1000);
    #if defined(HeadingMagHold) || defined(AeroQuadMega_CHR6DM)
      comma();
      Serial.print(compass.getAbsoluteHeading());
    #else
      comma();
      Serial.print('0');
    #endif
    #ifdef AltitudeHold
      comma();
      Serial.print(altitude.getData());
      comma();
      Serial.print(altitudeHold, DEC);
    #else
      comma();
      Serial.print('0');
      comma();
      Serial.print('0');
    #endif
    Serial.println();
    break;
   case 'T': // Send processed transmitter values
    Serial.print(receiver.getXmitFactor());
    comma();
    for (axis = ROLL; axis < LASTAXIS; axis++) {
      Serial.print(receiver.getData(axis));
      comma();
    }
    for (axis = ROLL; axis < YAW; axis++) {
      Serial.print(levelAdjust[axis]);
      comma();
    }
    Serial.print(motors.getMotorAxisCommand(ROLL));
    comma();
    Serial.print(motors.getMotorAxisCommand(PITCH));
    comma();
    Serial.println(motors.getMotorAxisCommand(YAW));
    break;
  case 'U': // Send smoothed receiver with Transmitter Factor applied values
    for (channel = ROLL; channel < AUX; channel++) {
      Serial.print(receiver.getData(channel));
      comma();
    }
    Serial.println(receiver.getData(AUX));
    break;
  case 'V': // Send receiver status
    for (channel = ROLL; channel < AUX; channel++) {
      Serial.print(receiver.getRaw(channel));
      comma();
    }
    Serial.println(receiver.getRaw(AUX));
    break;
  case 'X': // Stop sending messages
    break;
  case 'Z': // Send heading
    Serial.print(receiver.getData(YAW));
    comma();
    Serial.print(headingHold);
    comma();
    Serial.print(setHeading);
    comma();
    Serial.println(relativeHeading);
    break;
  case '6': // Report remote commands
    for (motor = FRONT; motor < LEFT; motor++) {
      Serial.print(motors.getRemoteCommand(motor));
      comma();
    }
    Serial.println(motors.getRemoteCommand(LEFT));
    break;
  case '!': // Send flight software version
    Serial.println(VERSION, 1);
    queryType = 'X';
    break;
  case '#': // Send software configuration
    // Determine which hardware is used to define max/min sensor values for Configurator plots
    #if defined(AeroQuad_v1)
      Serial.print('0');
    #elif defined(AeroQuadMega_v1)
      Serial.print('1');
    #elif defined(AeroQuad_v18)
      Serial.print('2');
    #elif defined(AeroQuadMega_v2)
      Serial.print('3');
    #elif defined(AeroQuad_Wii)
      Serial.print('4');
    #elif defined(AeroQuadMega_Wii)
      Serial.print('5');
    #elif defined(ArduCopter)
      Serial.print('6');
    #elif defined(Multipilot)
      Serial.print('7');
    #elif defined(MultipilotI2C)
      Serial.print('8');
    #elif defined(AeroQuadMega_CHR6DM)
          Serial.print('5');
    #endif
    comma();
    // Determine which motor flight configuration for Configurator GUI
    #if defined(plusConfig)
      Serial.print('0');
    #elif defined(XConfig)
      Serial.print('1');
    #elif defined(HEXACOAXIAL)
      Serial.print('2');
    #elif defined(HEXARADIAL)
      Serial.print('3');
    #endif
    Serial.println();
    queryType = 'X';
    break;  
  case 'e': // Send AREF value
    Serial.println(aref);
    queryType = 'X';
    break;
  case 'g': // Send magnetometer cal values
    #ifdef HeadingMagHold
      Serial.print(compass.getRange(XAXIS));
      comma();
      Serial.print(compass.getOffset(XAXIS));
      comma();
      Serial.print(compass.getRange(YAXIS));
      comma();
      Serial.print(compass.getOffset(YAXIS));
      comma();
      Serial.print(compass.getRange(ZAXIS));
      comma();
      Serial.println(compass.getOffset(ZAXIS));
    #endif
    queryType = 'X';
    break;
  }
}

// Used to read floating point values from the serial port
float readFloatSerial() {
  byte index = 0;
  byte timeout = 0;
  char data[128] = "";

  do {
    if (Serial.available() == 0) {
      delay(10);
      timeout++;
    }
    else {
      data[index] = Serial.read();
      timeout = 0;
      index++;
    }
  }  while ((data[constrain(index-1, 0, 128)] != ';') && (timeout < 5) && (index < 128));
  return atof(data);
}


void comma() {
  Serial.print(',');
}

void printInt(int data) {
  byte msb, lsb;
  
  msb = data >> 8;
  lsb = data & 0xff;
  
  Serial.print(msb, BYTE);
  Serial.print(lsb, BYTE);
}
