HonkStonk/AeroQuad/(commit log)

2009-03-29 Tested under Arduino 0015. Fixed comments for AeroQuad.
    [AeroQuad.pde, Sensors.pde]
2009-03-29 checking current baseline against Mega
2009-04-12 Added separate pitch PID
2009-04-18 Got new serial command set implmented in flight and ground station code.
2009-04-21 commented out user configurable receiver channel order from serial interface, currently not working correctly
    [AeroQuad.pde]
2009-04-22 Added ifdef's to allow users quick changes for receiver channel order and sensor pinouts. Nice if you have multiple quads setup a little different.
2009-05-06 2nd Order Complementary filter still under development. Added 490Hz update rate for ESC's/motors. Added keyboard ability to connect/disconnect to quad in Configurator.
2009-05-07 2nd Order Filter implemented. Auto Level works VERY well now! (still has minor drift)
    [AeroQuad.pde]
2009-05-14 Checked out autolevel with real flight. Removed ifdefs for 1st order complementary filter and average sensor data. Added capability to connect/disconnect Configurator using up/down arrow keys.
2009-05-16 Removed auto level as experimental from Configurator, fixed tab order of controls, moved all user configurable items to one screen, made auto level off value from transmitter configurable by user.
    [AeroQuad.pde]
2009-06-05 Implemented interrupt based method to read receiver values.
2009-06-21 Fixed bug in pin change interrupt #define statements
    [AeroQuad.pde, Sensors.pde]
2009-07-09 Added AeroQuad Shield 1.4 to repository
    [AeroQuad_v14.brd, AeroQuad_v14.sch]
2009-07-17 Implemented motor smoothing
2009-08-17 Bug fixes for throttle smoothing, updated transmitter comments
    [AeroQuad.pde]
2009-08-22 implemented first cut of camera stabilization routine
2009-08-31 Back of side projects.
    [Bottom.skp, BottomArm.skp, BottomSidePlate3D_125.skp, BottomSidePlate_125.dxf, BottomSidePlate_125.skp, BottomSide_125.skp, Bottom_125.skp, QuadrocopterArm(bottom-side).skp]
2009-09-01 Updated GUI for transmitter calibration
2009-09-05 reworking PCINT receiver code, modifying Configurator to initialize EEPROM and to calibrate transmitter
    [AeroQuad.pde, Sensors.pde]
2009-09-05 Added auto calibration to Configurator.
2009-09-05 Added auto calibration and default EEPROM.
2009-09-06 fixed spikes that fall within MAX/MIN
    [AeroQuad.pde]
2009-09-07 Implemented ESC calibration routines. Hooks are now in for computer control of AeroQuad flight.
2009-09-07 Implemented ESC calibration.
2009-09-08 Frame not ready for release
    [BottomSidePlate_125.dxf, QuadrocopterDesign.dxf]
2009-09-09 Added struts, made C channel, completed base plates
    [BasePlates.skp, Bottom.skp, BottomArm.skp, BottomSidePlate3D_125.skp, BottomSidePlate_125.skp, BottomSidePlate_Short.skp, BottomSidePlatev2.skp, BottomSide_125.skp]
2009-09-09 Separated files for manufacturing
    [BasePlates.skp, BottomSidePlate_Short.skp, QuadArms.skp, Xstruts.skp]
2009-09-09 Fixed Duemilanove mounting holes
    [BasePlates.skp]
2009-09-13 Optimixed transmiter min/max values. Fixed transmitter bug, where interrupts were not being turned off during reading of values.
    [AeroQuad.pde, Sensors.pde]
2009-09-13 Frame: Fixed layout of holes for mounting top plate. Submitted this version for fabrication.
    [BasePlates.skp, QuadArms3D.skp]
2009-09-16 Flight: Created analog input loop @ 500Hz, control loop @ 100Hz
2009-09-17 Configurator: prepping for v1.3.2 release, improved transmitter calibration process, added auto-reconnect feature, updated architecture for future v2.0 features
2009-09-23 Finished calculating heading from yaw gyro, need to implement transmitter heading next
2009-09-24 heading hold partially implemented
    [QuadArms.skp]
2009-09-25 updating heading hold (experimental), new quad frame design
    [BasePlates_v1.2.skp, BasePlates_v12.dxf, QuadArms_v1.2.dxf, QuadArms_v1.2.skp, QuadArms_v12.dxf, Quad_v1.2.skp, Quad_v12.dxf]
2009-09-30 removed analogWrite and are using Servo to improve PWM resolution. Must modify Servo.h with #define REFRESH_INTERVAL 4000 to work properly. Only works with Arduino 0017.
    [BasePlates_v12.dxf, QuadArms_v1.2.dxf, QuadArms_v12.dxf, Quad_v12.dxf]
2009-10-10 Configurator: Please note! AUX pin and Front Motor pin are swapped to be compatible with Arduino 017 Servo library (previous incompatibility with PCINT code). Includes experimental fast telemetry mod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
    [AeroQuad.h, AeroQuad.pde]
2009-10-11 Configurator: added individual motor commands and safety kill button
2009-10-13 Added low pass filter to Heading Hold, debugged Heading Hold screen in Configurator, added gyro and accel calibration buttons to Configurator
2009-10-14 added new pinouts for AQ 1.5 shield (may remove this in the future, ending up too complicated), fixed gyro cal bug, put in axis fix for ST yaw gyro, commented out camera stabilization code to move de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
    [AeroQuad.h, AeroQuad.pde, Motors.h, Receiver.h]
2009-10-22 debugged serial monitor
    [QuadFrame_v2.0.skp]
2009-10-24 Prepping for next releases of Configurator, Flight Software and Shield.
    [AeroQuad_v15.brd, AeroQuad_v15.sch, QuadFrame_v2.0.skp]
2009-10-25 Added additional safety around Configurator based motor commands. Updated default heading hold EEPROM value. Fixed default screens for manual motor commands.
    [AeroQuad.h, AeroQuad.pde, Sensors.pde]
2009-10-25 prepping for next release, fixed spelling mistakes and updated readme file, also officially removing ServoTimer2 library from development code
2009-10-28 Adding Arduino Mega receiver pin assignments, new AeroQuad frame use with 12mm circular tubes.
    [AeroQuadFrame_v2.0.skp, QuadFrame_v2.0.skp]
2009-10-30 attempting new auto level routine
    [12-5mmTubeMounts.skp, 12-7mmTubeMounts.skp]
2009-11-02 adding official support for Arduino Mega with AeroQuad Shield v1.x, prototyping auto zero function for gyros
2009-11-10 comparing MikroQuad Kalman Filter implementation with Complementary Filter
2009-11-18 Arduino Mega receiver code flight tested
2009-11-20 latest frame updates
    [12-7mmTubeMounts.skp, AeroQuadFrame_v2.1.skp]
2009-11-21 AQ Frame: extended bottom plate for landing gear
    [AeroQuadFrame_v2.1.skp]
2009-11-21 AQ: Frame resized slots and holes, simplified motor mount
    [AeroQuadFrame_v2.1.skp]
2009-11-26 Added roll cage to frame
    [AeroQuadFrame3D_v2.1.skp, AeroQuadFrame_v2.1.skp]
2009-12-23 Initial Check In
    [AeroQuad_v20.brd, AeroQuad_v20.sch]
2010-01-27 intermediate flow design
2010-01-29 Check in of AeroQuad 1.6 Shield
    [AeroQuad_v16.brd, AeroQuad_v16.sch]
2010-01-31 check in of v1.6 shield schematic in pdf format
2010-02-17 Added motor limit even algorithm
2010-02-18 added RoyLB comp filter fix
    [AeroQuad.h, AeroQuad.pde, Filter.h, Motors.h, Receiver.h, Sensors.pde]
2010-02-18 Added Filter and FlightAngle classes to 2009 code
2010-02-18 Added motor class
2010-02-21 returned zero accel and gyro to previous method
2010-03-01 new design for usage with AeroReceiver
    [AeroQuad_v20.brd, AeroQuad_v20.sch]
2010-03-01 minor change to max motor command when max motor commanded. needs flight testing.
2010-03-05 This release fixes a yaw bug that exhibits itself with the new capacitors installed which allows the user to use higher PID values. Also the comments were fixed to reflect usage of IDG500 or IXZ500 g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
    [AeroQuad.h, AeroQuad.pde, FlightAngle.h, Motors.h, Receiver.h, Sensors.pde]
2010-03-07 updated transmitter and calibration dialog boxes, implemented fix for issue #1
2010-03-18 adding accel calibration
2010-03-19 Created new Z axis calibration
2010-03-20 finalized z accel calibration, updating references to aref
2010-03-20 added ability to upload aref, new sensor cal buttons
2010-03-22 fixed heading hold for aref
    [AeroQuad.h, AeroQuad.pde, Motors.h]
2010-03-24 xed bug for Arduino Mega users. #define Mega_AQ1x was not defined before #include "Receiver.h". It accidentally caused the receiver pin assignments to use the Duemilanove assignments instead of the M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
    [AeroQuad.h, AeroQuad.pde, Filter.h, FlightAngle.h, Motors.h, Receiver.h, Sensors.pde]
2010-05-02 worked out tuning, tried new filter, best Stable Mode yet
2010-05-19 Adding ArduCopter PID control method (needs DCM)
2010-05-27 removed stability safety's from acro mode. configurator now supports front panel acro/stable mode change and front panel heading hold change
    [AeroQuad.pde]
2010-05-27 removed AUX switching from heading hold
2010-05-28 added FabQuad's gyro drift algorithm, enabled right click menus in Configurator
    [AeroQuad.pde]
2010-06-09 Updated architecture to make hardware communication drivers using C++ classes.
2010-06-15 fixing low pass filter issues
    [Accel.h, AeroQuad.h, AeroQuad.pde, DataStorage.h, Filter.h, FlightCommand.pde, FlightControl.pde, Gyro.h]
2010-06-15 created base class for gyros
2010-06-15 fixed sensor update to reload raw data page
2010-06-16 added Wii sensor support
2010-06-16 successfully tested both AeroQuad sensor and APM sensor classes
2010-06-24 successfully flight tested with APM and APM IMU
2010-06-25 cleaned up code for Wii sensor checkout
2010-07-07 defined motors class, added ITG3200 sensor
2010-07-07 optimized new gyro sensor, need to think about better class definition for sensors
2010-07-08 removed old AeroQuadAPM folder, updated measure method in gyro and accel classes
2010-07-08 flight tested new gyro
2010-07-09 flight tested with new accel, fixed calibration for negative values
    [Accel.h, Gyro.h, Sensors.pde, SerialCom.pde]
2010-07-24 fixed serious issue with CF and Kalman filters (made separate variables for each axis)
    [Accel.h, AeroQuad.h, AeroQuad.pde, FlightAngle.h, Gyro.h, Sensors.pde, SerialCom.pde]
2010-08-02 Experimental version! Investigating fixed point math.
    [AeroQuad.h, AeroQuad.pde, FlightAngle.h, Motors.h, Receiver.h]
2010-08-05 Modified Flight Software and Configurator back to changing flight modes with transmitter switch. Implemented round robin I2C reads for IMU sensors.
2010-08-17 fixed problem with xmitFactor for transmitter, flight tested with v1.8 AeroQuad Shield
    [Accel.h, AeroQuad.h, AeroQuad.pde, FlightAngle.h, Gyro.h, Motors.h, Receiver.h]
2010-08-27 updated correct scale values for ITG3200 and BMA180, fixed DCM to match
    [Accel.h, AeroQuad.h, FlightAngle.h, FlightControl.pde, Gyro.h, SerialCom.pde]
2010-08-30 flight tested new Stable Mode, need to updated default values for PID
2010-08-31 Adding AeroQuad Shield v1.8 to repository
    [AeroQuad_v18.brd, AeroQuad_v18.sch]
2010-08-31 Adding AeroQuad Shield v2.0 to repository
    [AeroQuad_v20.brd, AeroQuad_v20.sch, AeroQuad_v206.brd, AeroQuad_v206.sch]
2010-08-31 Adding pdf schematics for shields.
2010-09-03 Minor code size optimization for Duemilanove and I2C. Rearranged #define config for easier reading.
2010-09-10 unstable version - removed unnecessary #defines, added serial telemetry to determine software configuration to fix plot scales in Configurator
    [Accel.h, AeroQuad.pde, DataAcquisition.h, FlightAngle.h, Gyro.h, Motors.h, Receiver.h, SerialCom.pde]
2010-09-11 solved serious bug with Stable Mode, requires more flight testing
    [AeroQuad.pde, FlightControl.pde]
2010-09-14 fixed missing Integral gain in Stable Mode, fixed inverted pitch with v1.7/v1.6 shield, verified older v1.4 shield works with older IDG gyros
    [AeroQuad.pde, FlightControl.pde]
2010-09-15 fixed v1.7 and Wii sensor orientation, flight tested Wii shield with v1.8
    [Accel.h, AeroQuad.h, AeroQuad.pde, DataAcquisition.h, DataStorage.h, Filter.h, FlightAngle.h, FlightCommand.pde]
2010-09-16 Adding new serial commands to tell Configurator board setup and motor setup. Fixing sensor direction in Configurator.
    [AeroQuad.pde, SerialCom.pde]
2010-09-20 updated sensor directions for v1.7, Wii and ArduCopter. Fixed overflow bug on ArduCopter for EEPROM write and calibration times.
    [Accel.h, AeroQuad.h, AeroQuad.pde, DataAcquisition.h, DataStorage.h, FlightAngle.h, FlightCommand.pde, FlightControl.pde]
2010-09-20 Fixes for flight software listed in readme file. Preparing flight software and Configurator for next release.
    [DataStorage.h, SerialCom.pde]
2010-09-20 v3.0 frame
    [AeroQuadFrame_v3.dxf]
2010-09-22 adding magnetometer capability (not flight tested)
2010-09-26 fixed altitude measurement and added Configurator telemetry for heading and altitude.
    [AeroQuad.h, AeroQuad.pde, Altitude.h, Compass.h, FlightControl.pde, Sensors.pde, SerialCom.pde]
2010-09-26 fixed overflow bug with altitude measurement, flight tested heading hold, flight tested with altitude measurement on (no altitude hold yet)
    [AeroQuad.pde, Altitude.h]
2010-09-27 updated data types to address overflow bug for baro
    [AeroQuad.h, Altitude.h, FlightCommand.pde, FlightControl.pde, Receiver.h, SerialCom.pde]
2010-09-27 Added complementary filter to absolute heading to achieve +/-.5 deg resolution. Working on adding CF to heading hold.
2010-09-29 Changed CF for yaw to output +/-180 to use in heading hold. Absolute yaw now a different serial output telemetry. Heading hold will use relative heading (new heading always centered around zero) to a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
2010-09-30 fixed bug in heading when compass and gyro have different signs
    [Compass.h, FlightControl.pde]
2010-09-30 implemented new heading hold, still need to debug heading drift while motors on, looks like gyro drift is enough to affect CF with compass and gyro
    [AeroQuad.h, Compass.h, FlightControl.pde, Gyro.h, SerialCom.pde]
2010-10-04 debugging heading hold - do not fly with this version, looking to update yaw from gyro peridocially with compass
2010-10-10 Fixed bug with measuring ground altitude, first few measurements during init were bad causing bad ground altitude measurement. Need to figure out better smoothing for throttle adjust, too noisy causi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
    [AeroQuad.h, Altitude.h, FlightCommand.pde, SerialCom.pde]
2010-10-10 Added mods by SwiftingSpeed and Mgros. I2C transactions faster now!
2010-10-13 implemented median filter, after testing found it too slow, still debugging strange yaw gain when changing altitude PID
    [AeroQuad.h, AeroQuad.pde, Filter.h, FlightControl.pde, Receiver.h]
2010-10-14 Fixed bug where ALTITUDE was accidentally redefined, causing YAW and ALITITUDE to be the same. This caused false yaw change instead of throttle change for altitude hold. WIll flight test this weekend!
    [AeroQuad.h, SerialCom.pde]
2010-10-15 flight testing / PID tuning altitude hold (not finished yet), separated compass/barometer with #defines
2010-10-18 Implementing Z Axis dampening (not finished yet).
2010-10-20 added PID for Z Axis dampening (not flight tested)
2010-10-20 Problems with Z Axis dampening, BMA180 filtering causes 1G measurement to change
    [Accel.h, AeroQuad.pde, DataStorage.h, FlightCommand.pde, FlightControl.pde, SerialCom.pde]
2010-10-22 Closed issues 33, 34, 35, 36. Updated Configurator to show correct AREF values.
    [AeroQuad.pde, DataStorage.h, FlightAngle.h, Gyro.h]
2010-11-01 fixing altitude hold (not flight tested)
    [Accel.h, AeroQuad.h, Altitude.h, DataStorage.h, FlightCommand.pde, FlightControl.pde, SerialCom.pde]
2010-11-05 Implemented AeroQuad code to read CHR6dM. Sensor values are off scale at the moment
2010-11-05 Reading CHR6DM estimated angles directly, bypassing the ususal flightangle filter
2010-11-06 Implementing mag calibration (not flight tested)
2010-11-07 debugging magnetometer calibration
2010-11-07 Removed println to Serial - that could possibly upset configurator
2010-11-09 added mag calibration to Configurator (not flight tested)
2010-11-11 Jittery accel fixed! :D
    [CHR6DM.h]
